arsenal007/TRX_UT3MK_v23/README.md

# TRX_UT3MK_v23
MAINBOARD for UT3MK v23.01
