arsenal007/TRX_UT3MK_v23/INPUTS/2976185.jpg

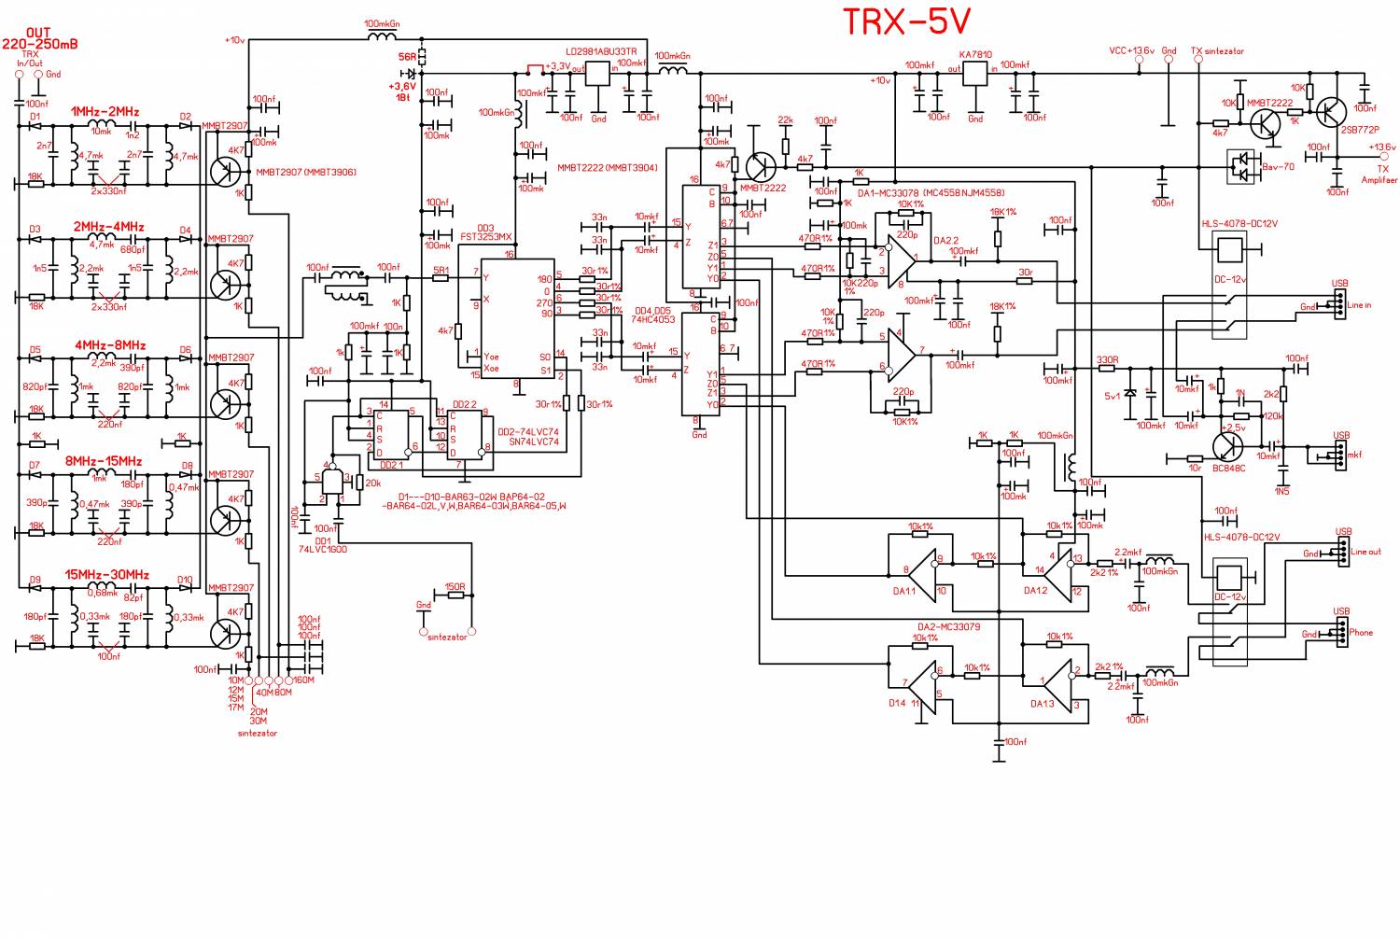
INPUTS/2976185.jpg
