arsenal007/TRX_UT3MK_v23/INPUTS/4894993.jpg

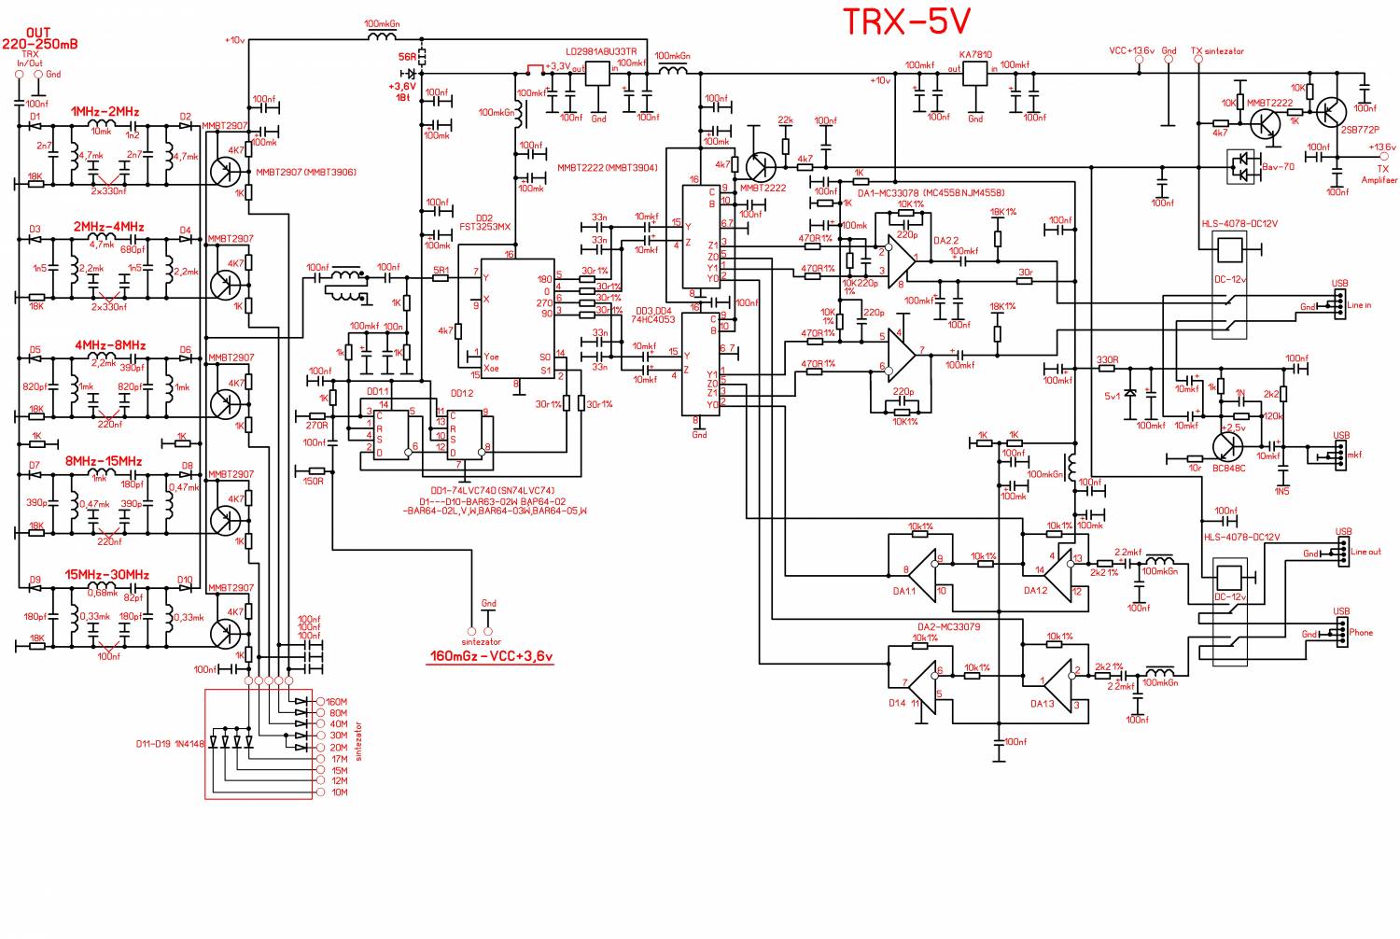
INPUTS/4894993.jpg
