arsenal007/TRX_UT3MK_v23/INPUTS/5522116.jpg

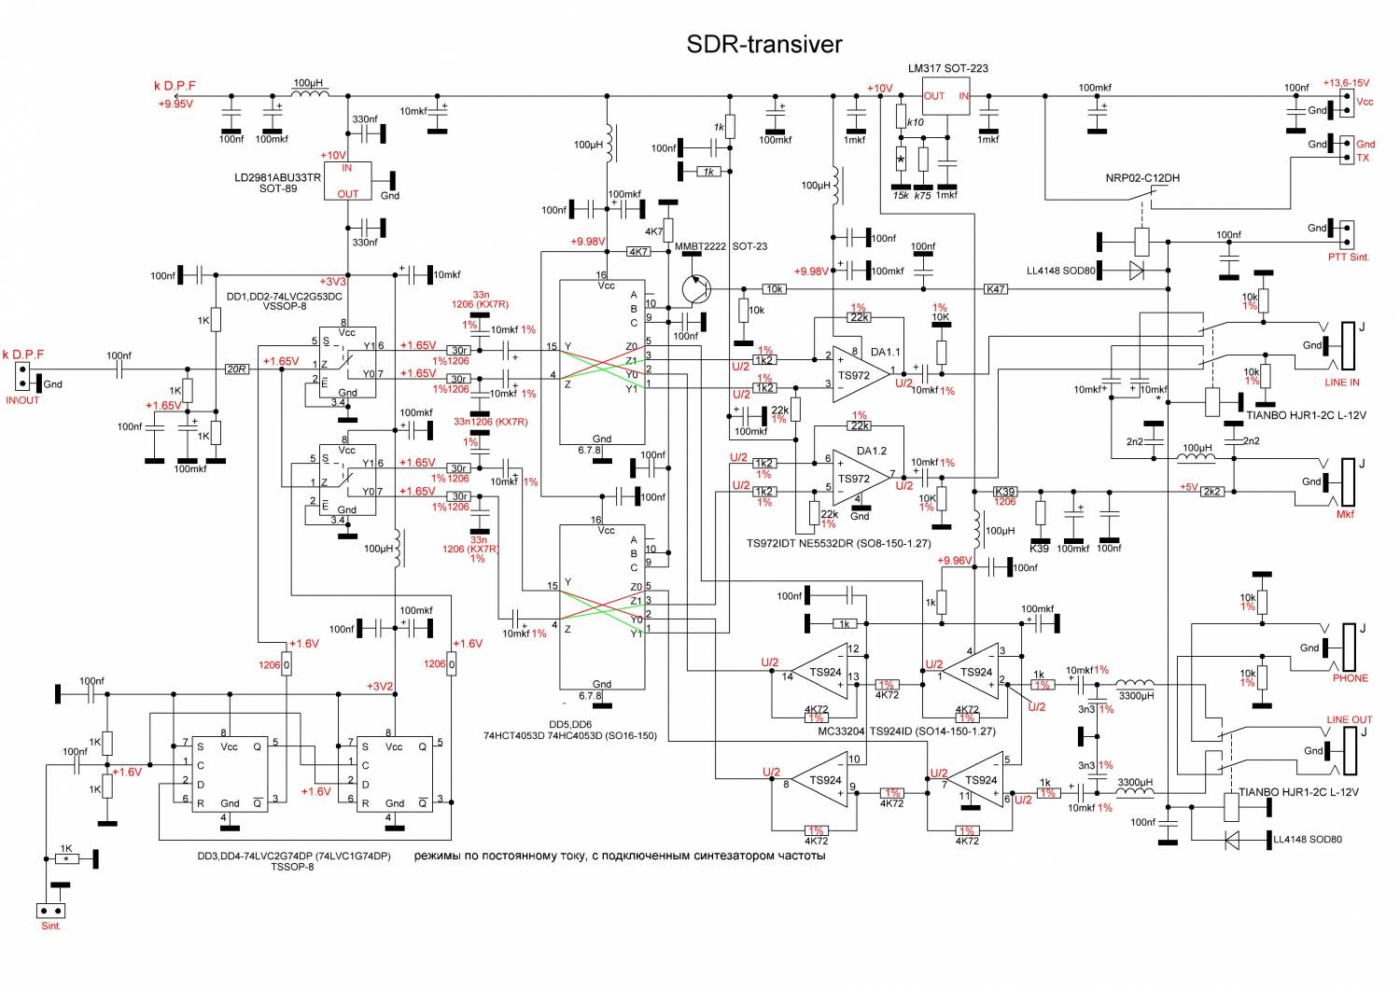
INPUTS/5522116.jpg
