arsenal007/TRX_UT3MK_v23/INPUTS/8518933.jpg

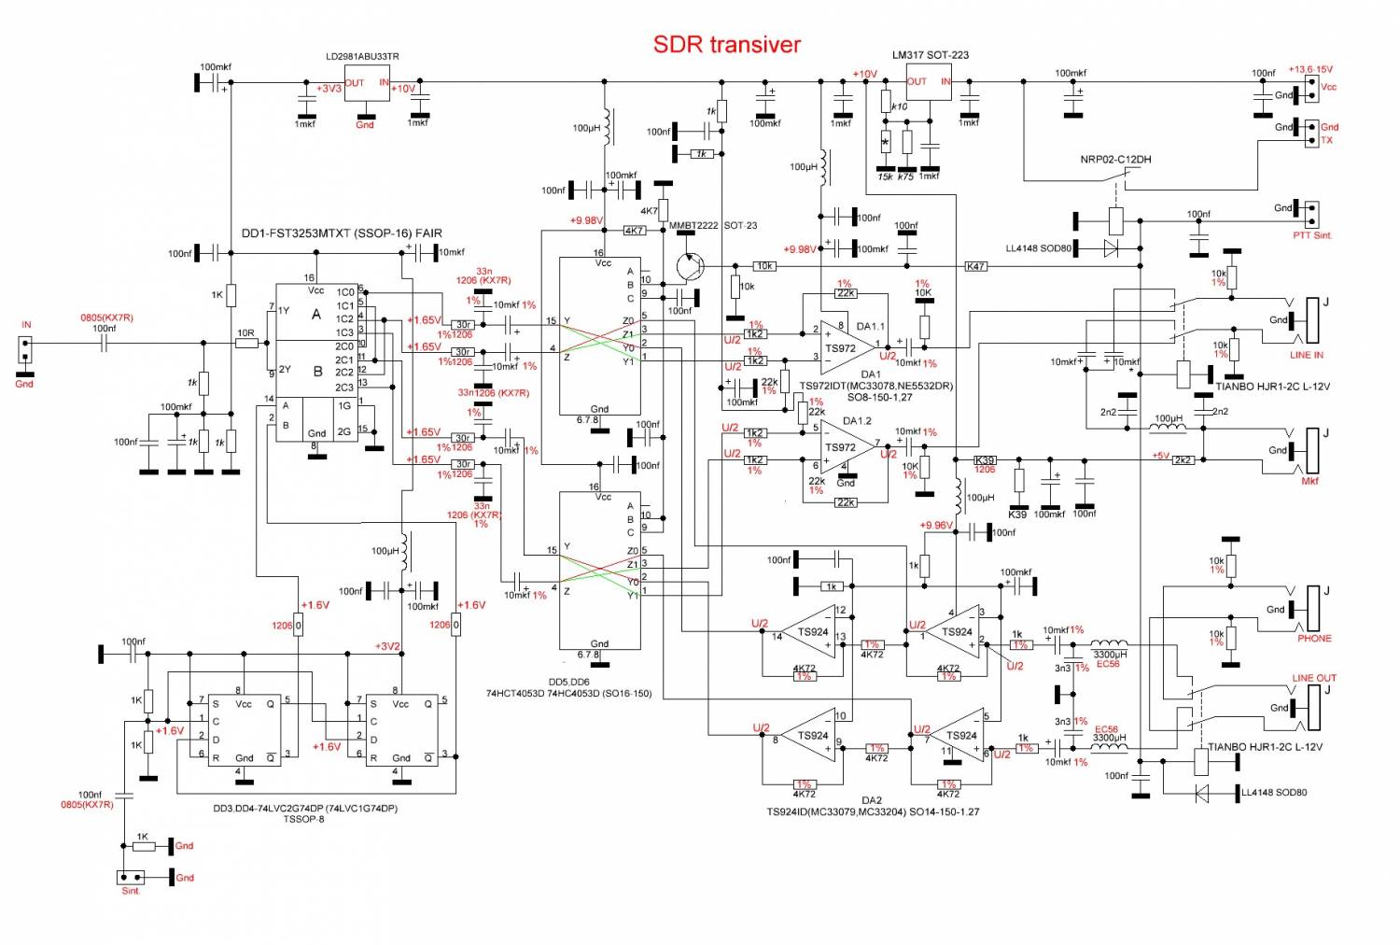
INPUTS/8518933.jpg
