arsenal007/TRX_UT3MK_v23/(list of files, drawings)

Other design files:
74HC74.ms12
