arsenal007/TRX_UT3MK_v23/LCSDR.kicad_pcb

## KiCad design LCSDR.kicad_pcb (2020-07-06)

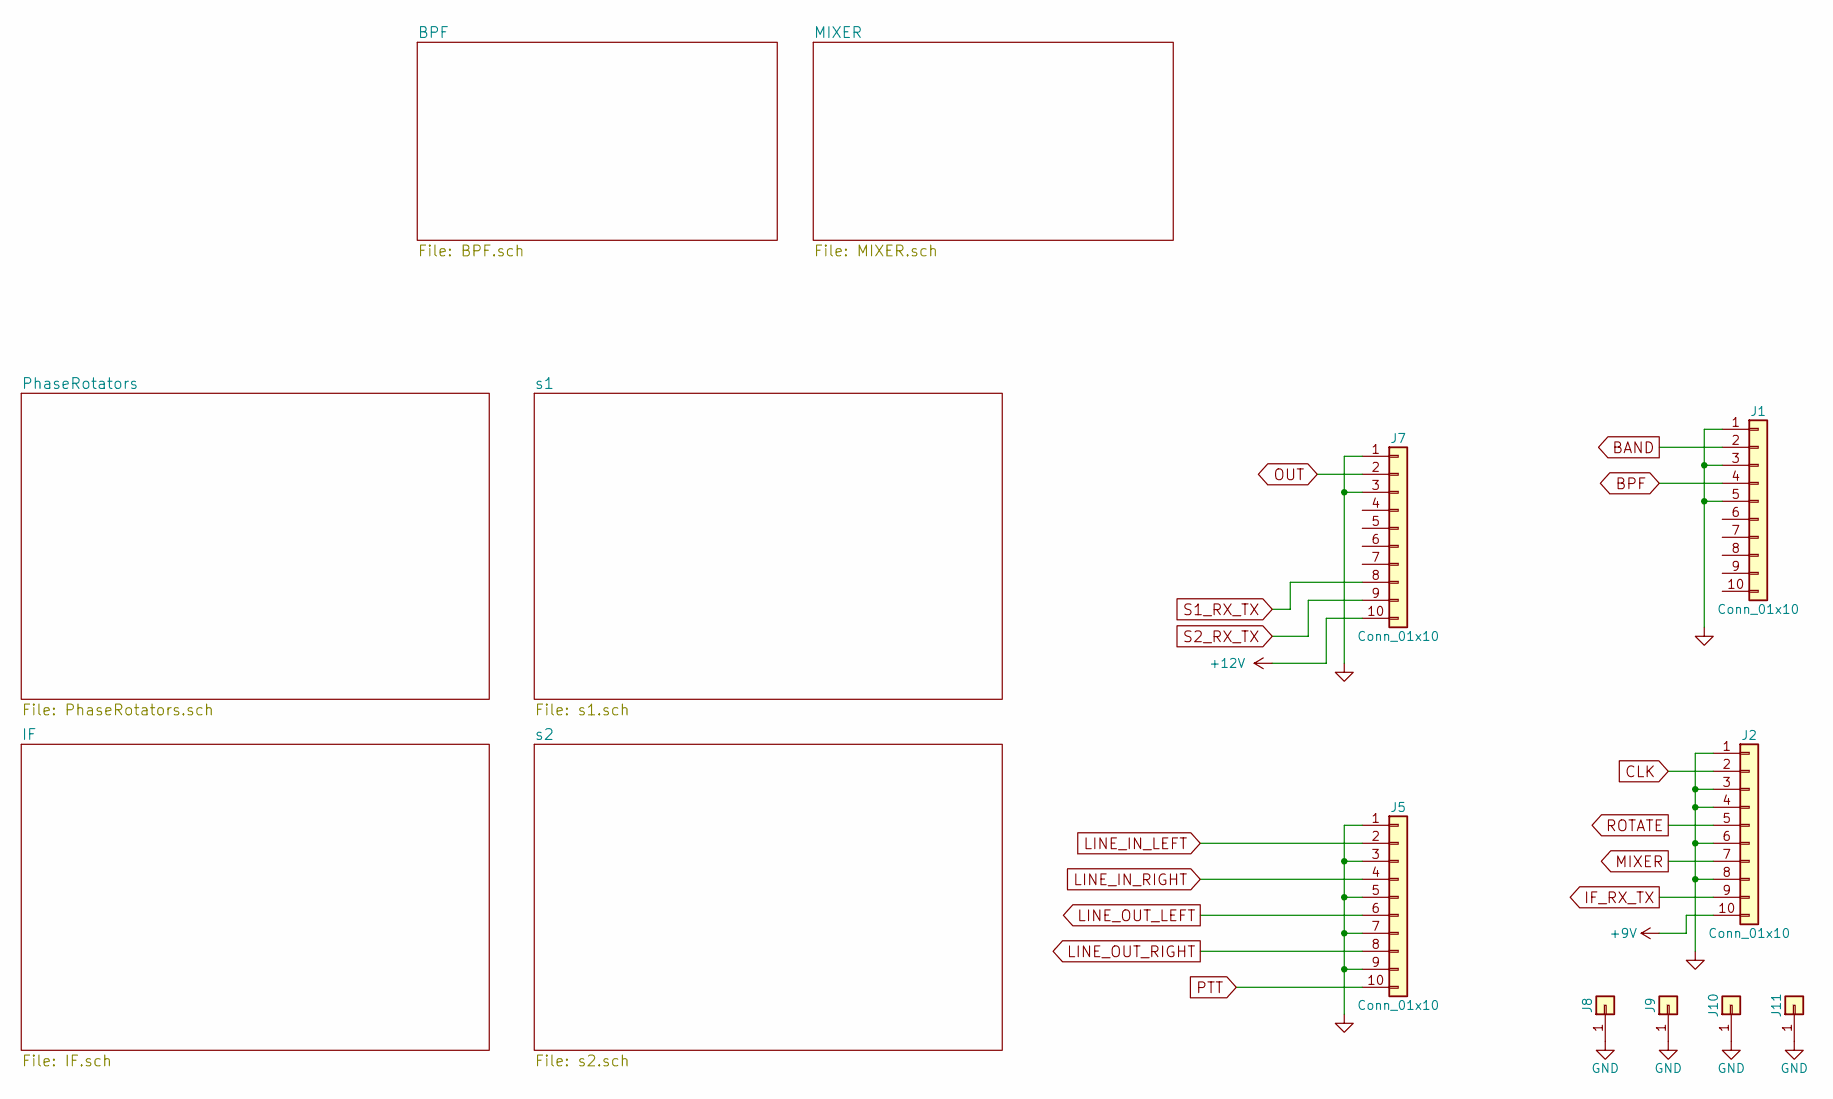
[picture p5: schematic LCSDR.sch, Hermes-Lite]

Parts:
J1, J2, J5, J7: Conn_01x10; Pin_Header_Straight_1x10_Pitch2.54mm
J8, J9, J10, J11: Conn_01x01; MountingHole_3.2mm_M3_DIN965_Pad

Connections:
+9V: J2.10; also elsewhere on the board
+12V: J7.10; also elsewhere on the board
BAND: J1.2; also elsewhere on the board
BPF: J1.4; also elsewhere on the board
CLK: J2.2; also elsewhere on the board
GND: J1.1, J1.3, J1.5, J2.1, J2.3, J2.4, J2.6, J2.8, J5.1, J5.3, J5.5, J5.7, J5.9, J7.1, J7.3, J8.1, J9.1, J10.1, J11.1; also elsewhere on the board
IF_RX_TX: J2.9; also elsewhere on the board
LINE_IN_LEFT: J5.2; also elsewhere on the board
LINE_IN_RIGHT: J5.4; also elsewhere on the board
LINE_OUT_LEFT: J5.6; also elsewhere on the board
LINE_OUT_RIGHT: J5.8; also elsewhere on the board
MIXER: J2.7; also elsewhere on the board
OUT: J7.2; also elsewhere on the board
PTT: J5.10; also elsewhere on the board
ROTATE: J2.5; also elsewhere on the board
S1_RX_TX: J7.8; also elsewhere on the board
S2_RX_TX: J7.9; also elsewhere on the board

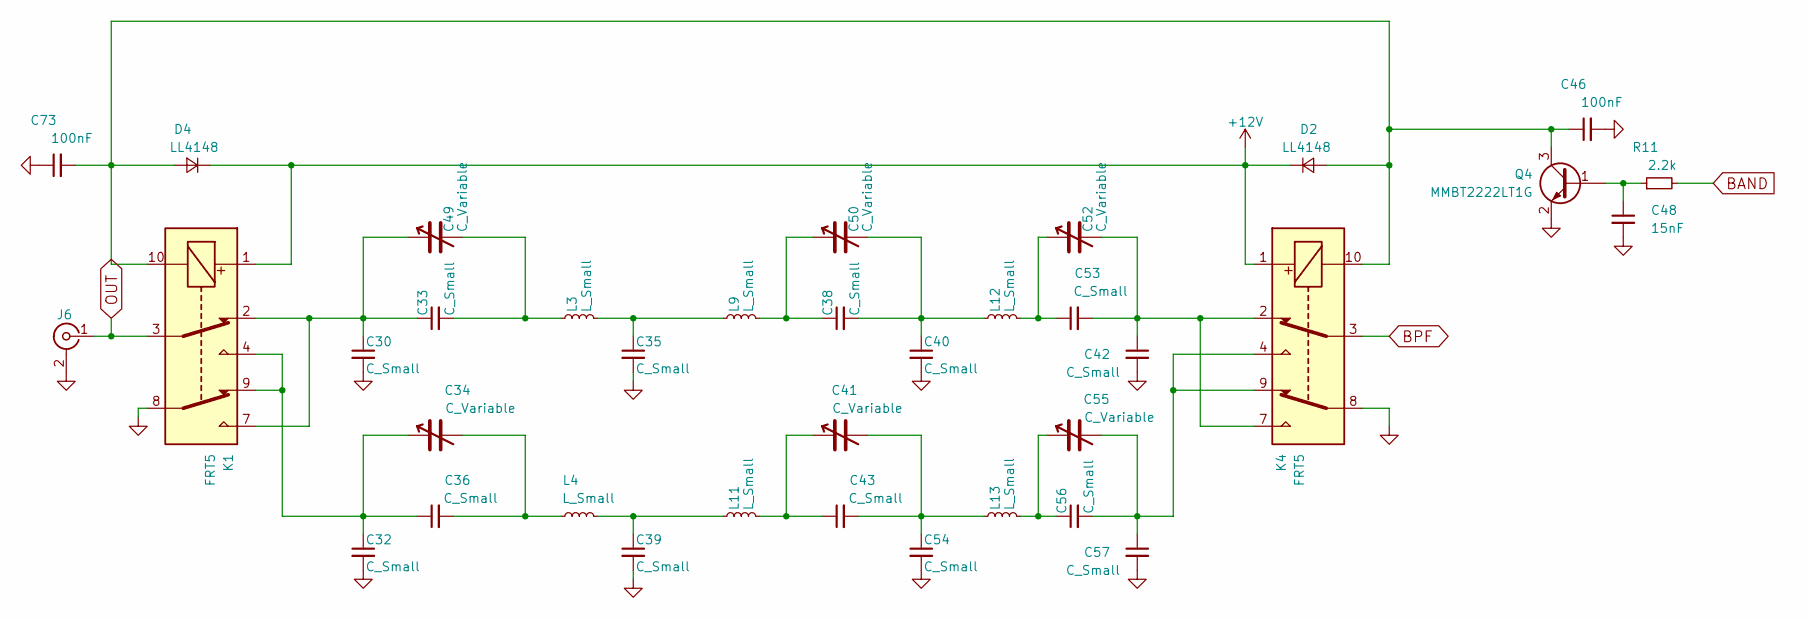
[picture p6: schematic BPF.sch]

Parts:
C30, C32, C33, C35, C36, C38, C39, C40, C42, C43, C53, C54, C56, C57: C_Small; C_1206_0603
C34, C41, C49, C50, C52, C55: C_Variable; C_Trimmer_Murata_TZC3
C46, C73: 100nF; C_1206_0603
C48: 15nF; C_0603_HandSoldering
D2, D4: LL4148; D_MiniMELF
J6: Conn_Coaxial; RFCONNECTOR
K1, K4: FRT5; Relay_DPDT_FRT5
L3, L4, L9, L11, L12, L13: L_Small; Choke_Toroid_6,5x13mm_Vertical
Q4: MMBT2222LT1G; SOT-23
R11: 2.2k; R_1206_0603

Connections:
+12V: D2.1 (K), D4.1 (K), K1.1, K4.1; also elsewhere on the board
BAND: R11.2; also elsewhere on the board
BPF: K4.3; also elsewhere on the board
GND: C30.2, C32.2, C35.2, C39.2, C40.2, C42.2, C46.2, C48.2, C54.2, C57.2, C73.1, J6.2 (Ext), K1.8, K4.8, Q4.2 (E); also elsewhere on the board
unnamed: C30.1, C33.1, C49.1, K1.2, K1.7
unnamed: C32.1, C34.1, C36.1, K1.4, K1.9
unnamed: C33.2, C49.2, L3.1
unnamed: C34.2, C36.2, L4.1
unnamed: C35.1, L3.2, L9.1
unnamed: C38.1, C50.1, L9.2
unnamed: C38.2, C40.1, C50.2, L12.1
unnamed: C39.1, L4.2, L11.1
unnamed: C41.1, C43.1, L11.2
unnamed: C41.2, C43.2, C54.1, L13.1
unnamed: C42.1, C52.2, C53.2, K4.2, K4.7
unnamed: C46.1, C73.2, D2.2 (A), D4.2 (A), K1.10, K4.10, Q4.3 (C)
unnamed: C48.1, Q4.1 (B), R11.1
unnamed: C52.1, C53.1, L12.2
unnamed: C55.1, C56.1, L13.2
unnamed: C55.2, C56.2, C57.1, K4.4, K4.9
OUT: J6.1 (In), K1.3; also elsewhere on the board

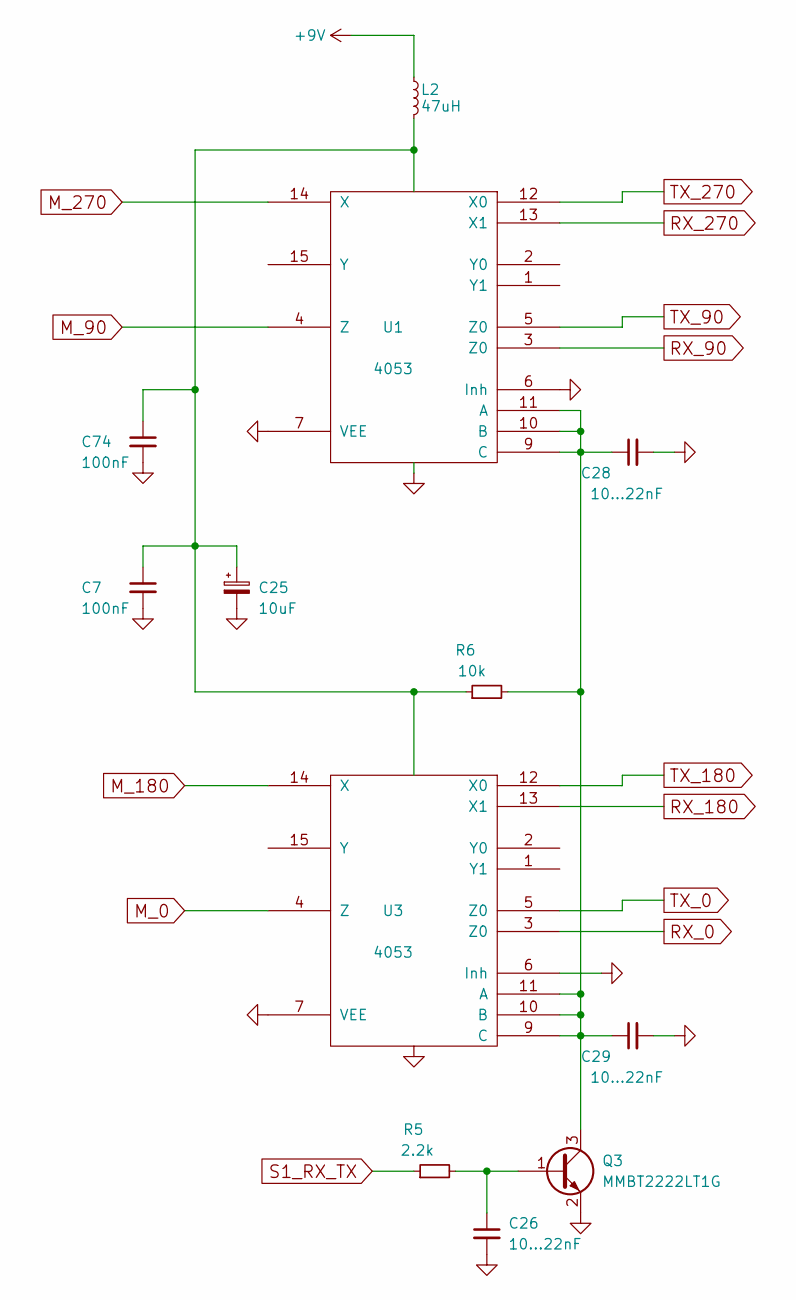
[picture p7: schematic s1.sch]

Parts:
C7, C74: 100nF; C_1206_0603
C25: 10uF; CP_Radial_D5.0mm_P2.00mm
C26, C28, C29: 10...22nF; C_0603_HandSoldering
L2: 47uH; Choke_Horizontal_RM10mm
Q3: MMBT2222LT1G; SOT-23
R5: 2.2k; R_1206_0603
R6: 10k; R_0603_HandSoldering
U1, U3: 4053; TSSOP-16_4.4x5mm_Pitch0.65mm

Connections:
+9V: L2.1; also elsewhere on the board
GND: C7.2, C25.2, C26.2, C28.2, C29.2, C74.2, Q3.2 (E), U1.6 (Inh), U1.7 (VEE), U1.8 (VSS), U3.6 (Inh), U3.7 (VEE), U3.8 (VSS); also elsewhere on the board
M_0: U3.4 (Z); also elsewhere on the board
M_90: U1.4 (Z); also elsewhere on the board
M_180: U3.14 (X); also elsewhere on the board
M_270: U1.14 (X); also elsewhere on the board
unnamed: C26.1, Q3.1 (B), R5.2
unnamed: C28.1, C29.1, Q3.3 (C), R6.2, U1.9 (C), U1.10 (B), U1.11 (A), U3.9 (C), U3.10 (B), U3.11 (A)
RX_0: U3.3 (Z0); also elsewhere on the board
RX_90: U1.3 (Z0); also elsewhere on the board
RX_180: U3.13 (X1); also elsewhere on the board
RX_270: U1.13 (X1); also elsewhere on the board
S1_RX_TX: R5.1; also elsewhere on the board
TX_0: U3.5 (Z0); also elsewhere on the board
TX_90: U1.5 (Z0); also elsewhere on the board
TX_180: U3.12 (X0); also elsewhere on the board
TX_270: U1.12 (X0); also elsewhere on the board
VDD: C7.1, C25.1, C74.1, L2.2, R6.1, U1.16 (VDD), U3.16 (VDD)

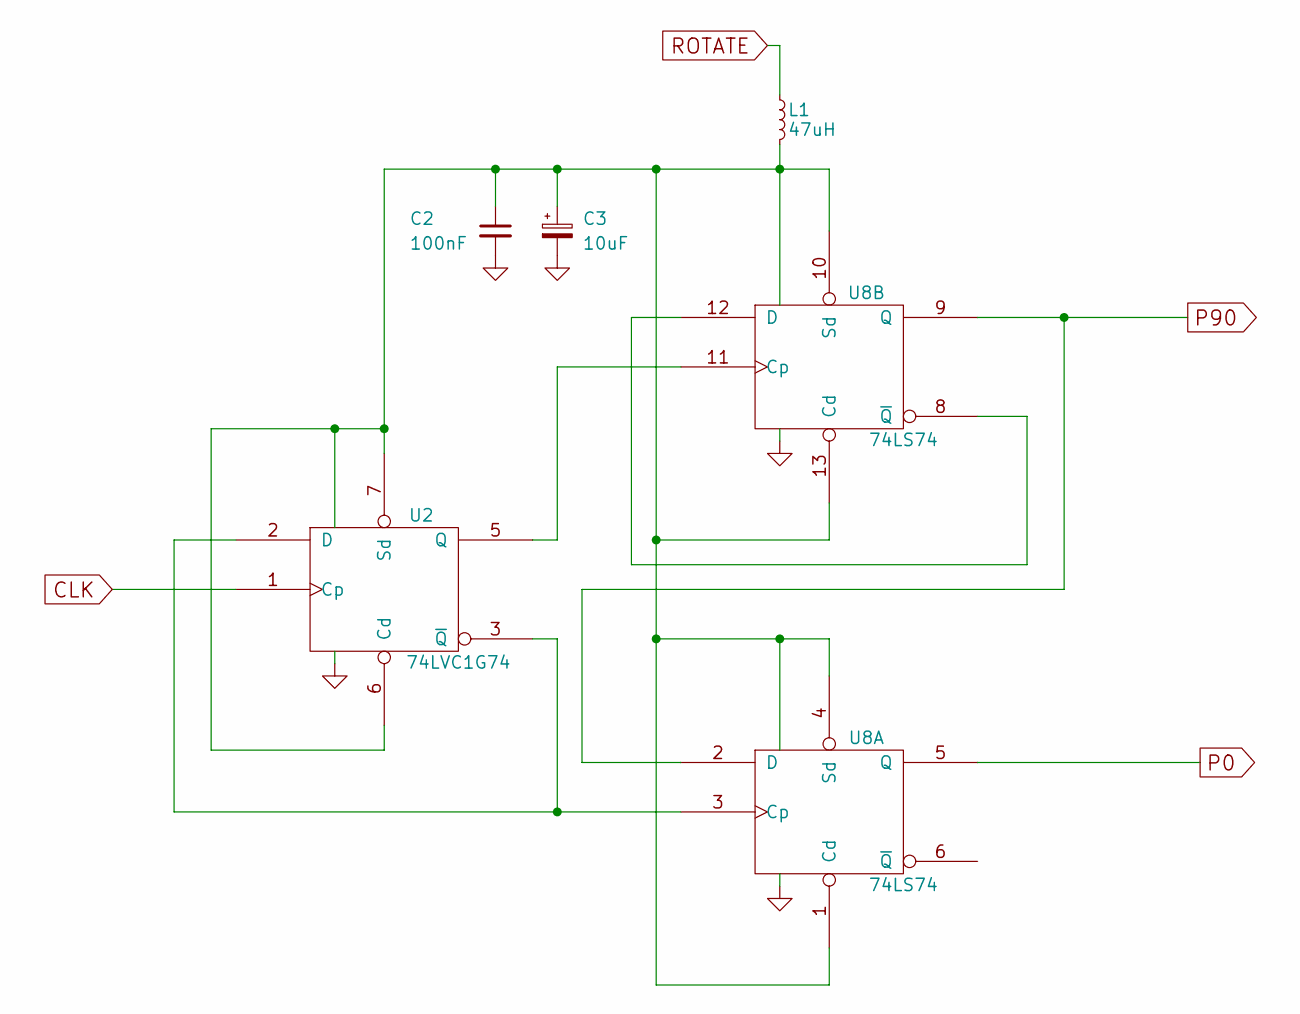
[picture p8: schematic PhaseRotators.sch]

Parts:
C2: 100nF; C_1206_0603
C3: 10uF; CP_Radial_D5.0mm_P2.00mm
L1: 47uH; Choke_Horizontal_RM10mm
U2: 74LVC1G74; TSSOP-8_3x3mm_Pitch0.65mm
U8: 74LS74; TSSOP-14_4.4x5mm_Pitch0.65mm

Connections:
CLK: U2.1 (Cp); also elsewhere on the board
GND: C2.2, C3.2, U2.4 (GND), U8.7 (GND); also elsewhere on the board
unnamed: U2.2 (D), U2.3 (~Q), U8.3 (Cp)
unnamed: U2.5 (Q), U8.11 (Cp)
unnamed: U8.8 (~Q), U8.12 (D)
P0: U8.5 (Q); also elsewhere on the board
P90: U8.2 (D), U8.9 (Q); also elsewhere on the board
ROTATE: L1.1; also elsewhere on the board
VCC: C2.1, C3.1, L1.2, U2.6 (Cd), U2.7 (Sd), U2.8 (VCC), U8.1 (Cd), U8.4 (Sd), U8.10 (Sd), U8.13 (Cd), U8.14 (VCC)

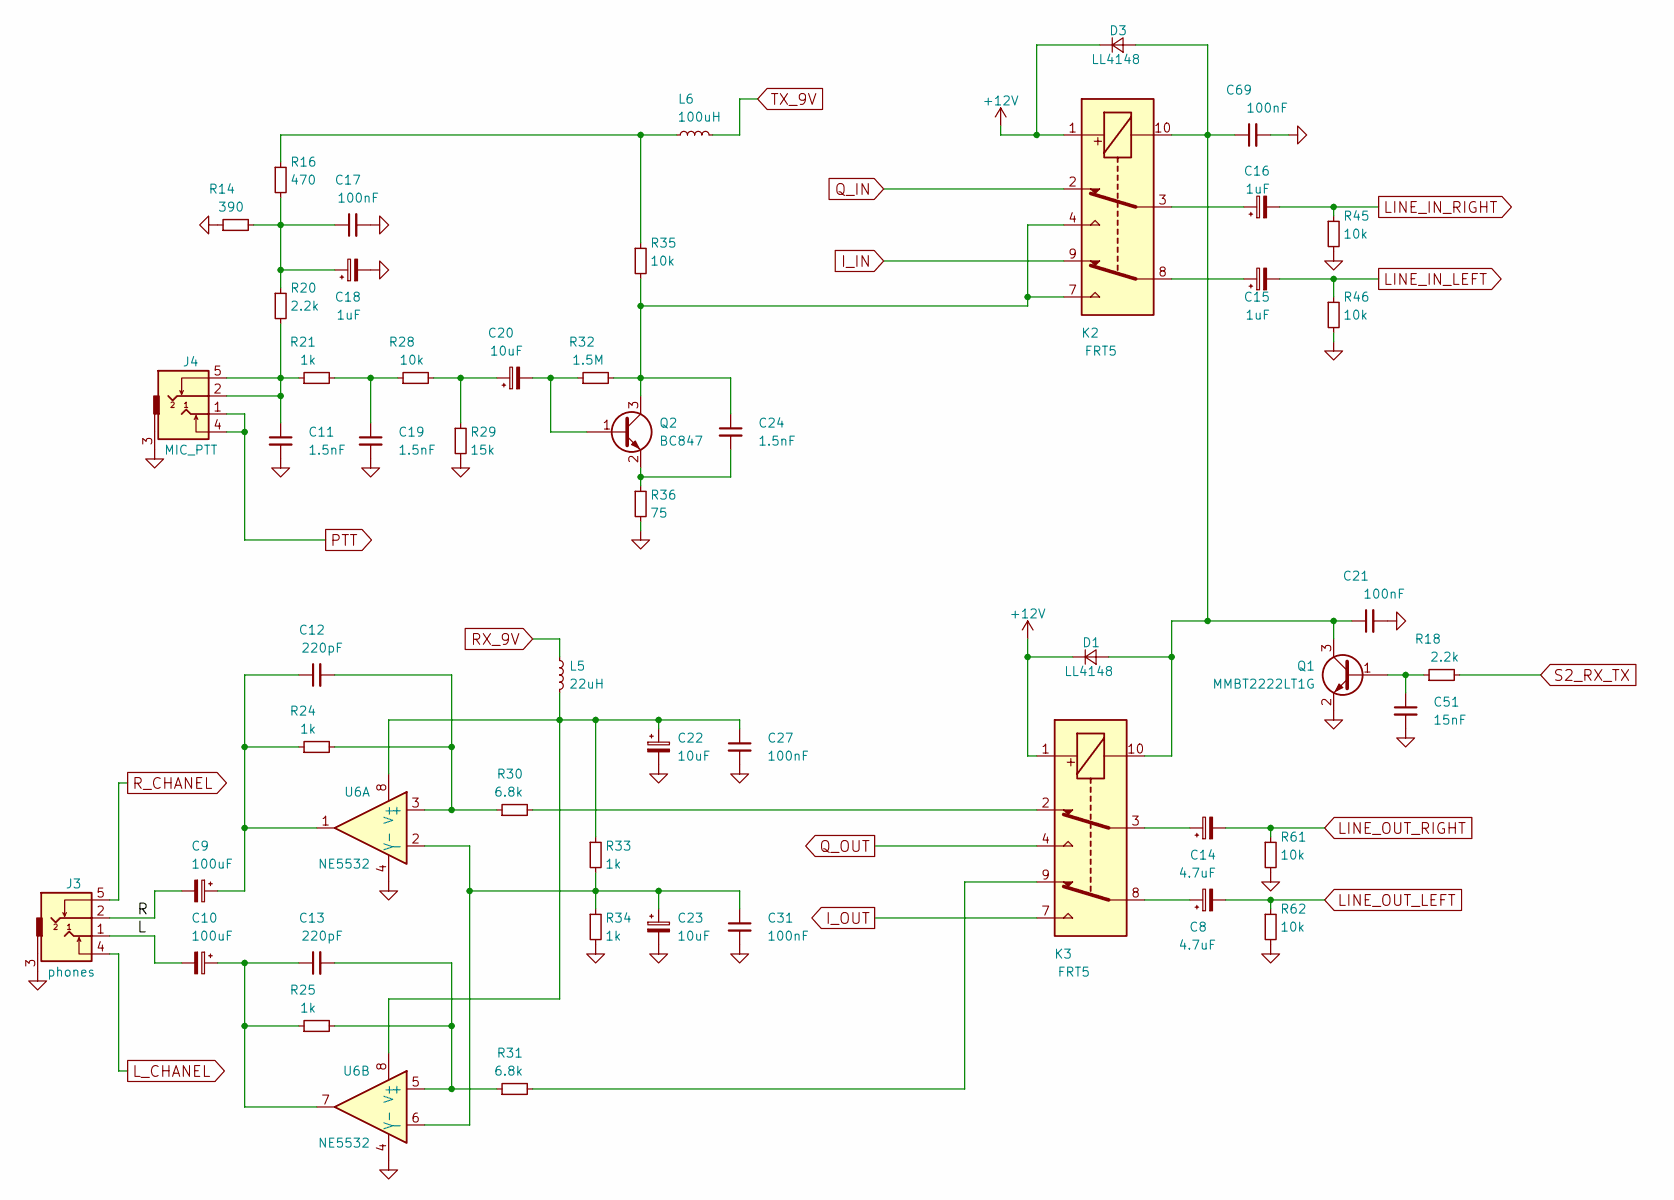
[picture p9: schematic s2.sch]

Parts:
C8, C14: 4.7uF; CP_Radial_D5.0mm_P2.00mm
C9, C10: 100uF; CP_Radial_D6.3mm_P2.50mm
C11, C19, C24: 1.5nF; C_1206_0603
C12, C13: 220pF; C_1206_0603
C15, C16, C18: 1uF; CP_Radial_D5.0mm_P2.00mm
C17, C21, C27, C31, C69: 100nF; C_1206_0603
C20, C22, C23: 10uF; CP_Radial_D5.0mm_P2.00mm
C51: 15nF; C_0603_HandSoldering
D1, D3: LL4148; D_MiniMELF
J3: phones; audio_jack_3_5mm_PJ307
J4: MIC_PTT; audio_jack_3_5mm_PJ307
K2, K3: FRT5; Relay_DPDT_FRT5
L5: 22uH; Choke_Horizontal_RM10mm
L6: 100uH; Choke_Horizontal_RM10mm
Q1: MMBT2222LT1G; SOT-23
Q2: BC847; SOT-23
R14: 390; R_1206_0603
R16: 470; R_1206_0603
R18, R20: 2.2k; R_1206_0603
R21, R24, R25, R33, R34: 1k; R_1206_0603
R28, R35, R45, R46, R61, R62: 10k; R_1206_0603
R29: 15k; R_1206_0603
R30, R31: 6.8k; R_1206_0603
R32: 1.5M; R_1206_0603
R36: 75; R_1206_0603
U6: NE5532; SOIC-8_3.9x4.9mm_Pitch1.27mm

Connections:
+12V: D1.1 (K), D3.1 (K), K2.1, K3.1; also elsewhere on the board
/s2/L: C10.2, J3.1
/s2/R: C9.2, J3.2
GND: C11.2, C17.2, C18.2, C19.2, C21.2, C22.2, C23.2, C27.2, C31.2, C51.2, C69.2, J3.3, J4.3, Q1.2 (E), R14.1, R29.2, R34.2, R36.2, R45.2, R46.2, R61.2, R62.2, U6.4 (V-); also elsewhere on the board
I_IN: K2.9; also elsewhere on the board
I_OUT: K3.7; also elsewhere on the board
LINE_IN_LEFT: C15.2, R46.1; also elsewhere on the board
LINE_IN_RIGHT: C16.2, R45.1; also elsewhere on the board
LINE_OUT_LEFT: C8.2, R62.1; also elsewhere on the board
LINE_OUT_RIGHT: C14.2, R61.1; also elsewhere on the board
unnamed: C8.1, K3.8
unnamed: C10.1, C13.1, R25.1, U6.7
unnamed: C11.1, J4.2, J4.5, R20.2, R21.1
unnamed: C9.1, C12.1, R24.1, U6.1
unnamed: C12.2, R24.2, R30.1, U6.3 (+)
unnamed: C13.2, R25.2, R31.1, U6.5 (+)
unnamed: C14.1, K3.3
unnamed: C15.1, K2.8
unnamed: C16.1, K2.3
unnamed: C17.1, C18.1, R14.2, R16.2, R20.1
unnamed: C19.1, R21.2, R28.1
unnamed: C20.1, R28.2, R29.1
unnamed: C20.2, Q2.1 (B), R32.1
unnamed: C21.1, C69.1, D1.2 (A), D3.2 (A), K2.10, K3.10, Q1.3 (C)
unnamed: C22.1, C27.1, L5.2, R33.1, U6.8 (V+)
unnamed: C23.1, C31.1, R33.2, R34.1, U6.2 (-), U6.6 (-)
unnamed: C24.1, K2.4, K2.7, Q2.3 (C), R32.2, R35.2
unnamed: C24.2, Q2.2 (E), R36.1
unnamed: C51.1, Q1.1 (B), R18.1
unnamed: K3.2, R30.2
unnamed: K3.9, R31.2
unnamed: L6.1, R16.1, R35.1
PTT: J4.1, J4.4; also elsewhere on the board
Q_IN: K2.2; also elsewhere on the board
Q_OUT: K3.4; also elsewhere on the board
RX_9V: L5.1; also elsewhere on the board
S2_RX_TX: R18.2; also elsewhere on the board
TX_9V: L6.2; also elsewhere on the board

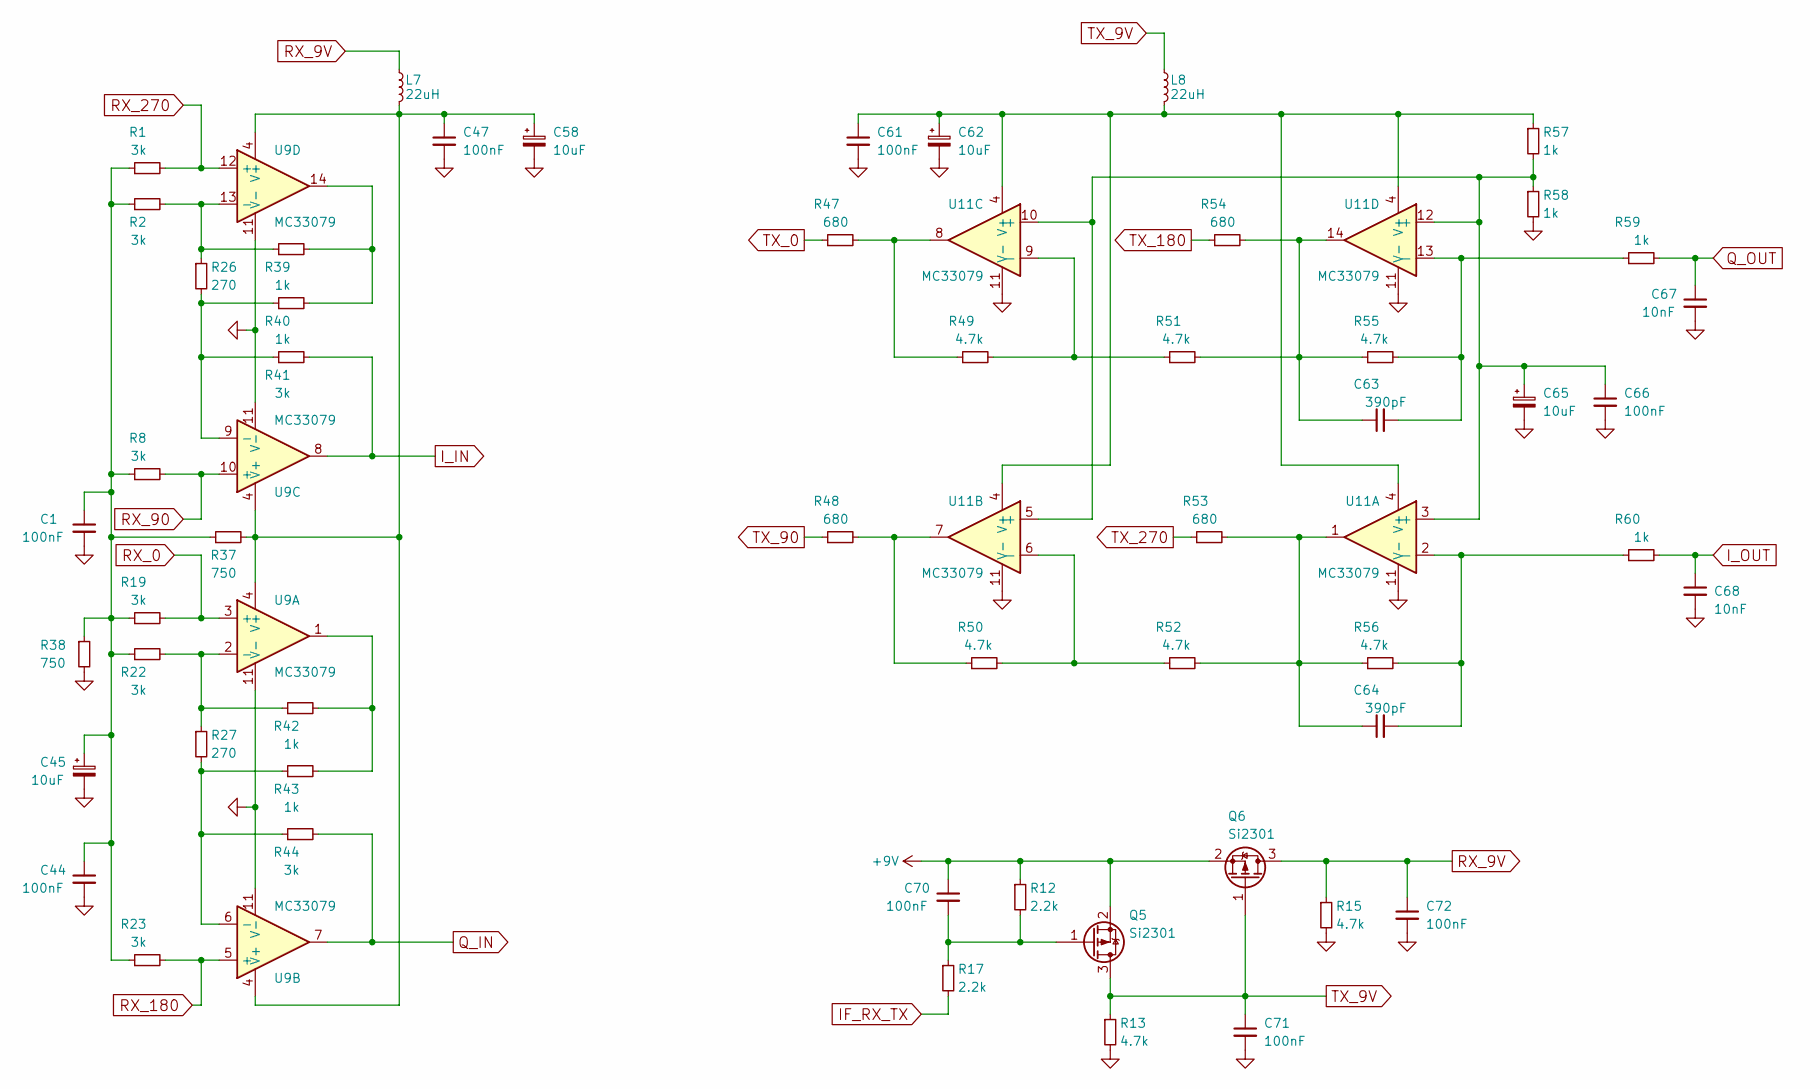
[picture p10: schematic IF.sch]

Parts:
C1, C44, C47, C61, C66, C70, C71, C72: 100nF; C_1206_0603
C45, C58, C62, C65: 10uF; CP_Radial_D5.0mm_P2.00mm
C63, C64: 390pF; C_0603_HandSoldering
C67, C68: 10nF; C_0603_HandSoldering
L7: 22uH; Choke_Horizontal_RM10mm
L8: 22uH; Choke_Horizontal_RM15mm
Q5, Q6: Si2301; SOT-23
R1, R2, R8, R19, R22, R23, R41, R44: 3k; R_0603_HandSoldering
R12, R17: 2.2k; R_1206_0603
R13, R15: 4.7k; R_1206_0603
R26, R27: 270; R_0603_HandSoldering
R37, R38: 750; R_1206_0603
R39, R40, R42, R43, R59, R60: 1k; R_0603_HandSoldering
R47, R48, R53, R54: 680; R_0603_HandSoldering
R49, R50, R51, R52, R55, R56: 4.7k; R_0603_HandSoldering
R57, R58: 1k; R_1206_0603
U9, U11: MC33079; SOIC-14_3.9x8.7mm_Pitch1.27mm

Connections:
+9V: C70.1, Q5.2 (S), Q6.2 (S), R12.1; also elsewhere on the board
GND: C1.2, C44.2, C45.2, C47.2, C58.2, C61.2, C62.2, C65.2, C66.2, C67.2, C68.2, C71.2, C72.2, R13.2, R15.2, R38.2, R58.2, U9.11 (V-), U11.11 (V-); also elsewhere on the board
IF_RX_TX: R17.2; also elsewhere on the board
I_IN: R41.2, U9.8; also elsewhere on the board
I_OUT: C68.1, R60.2; also elsewhere on the board
unnamed: C1.1, C44.1, C45.1, R1.1, R2.1, R8.1, R19.1, R22.1, R23.1, R37.1, R38.1
unnamed: C47.1, C58.1, L7.2, R37.2, U9.4 (V+)
unnamed: C61.1, C62.1, L8.2, R57.1, U11.4 (V+)
unnamed: C63.1, R51.2, R54.2, R55.1, U11.14
unnamed: C63.2, R55.2, R59.1, U11.13 (-)
unnamed: C64.1, R52.2, R53.2, R56.1, U11.1
unnamed: C64.2, R56.2, R60.1, U11.2 (-)
unnamed: C65.1, C66.1, R57.2, R58.1, U11.3 (+), U11.5 (+), U11.10 (+), U11.12 (+)
unnamed: C70.2, Q5.1 (G), R12.2, R17.1
unnamed: R2.2, R26.1, R39.1, U9.13 (-)
unnamed: R22.2, R27.1, R42.1, U9.2 (-)
unnamed: R26.2, R40.1, R41.1, U9.9 (-)
unnamed: R27.2, R43.1, R44.1, U9.6 (-)
unnamed: R39.2, R40.2, U9.14
unnamed: R42.2, R43.2, U9.1
unnamed: R47.2, R49.1, U11.8
unnamed: R48.2, R50.1, U11.7
unnamed: R49.2, R51.1, U11.9 (-)
unnamed: R50.2, R52.1, U11.6 (-)
Q_IN: R44.2, U9.7; also elsewhere on the board
Q_OUT: C67.1, R59.2; also elsewhere on the board
RX_0: R19.2, U9.3 (+); also elsewhere on the board
RX_9V: C72.1, L7.1, Q6.3 (D), R15.1; also elsewhere on the board
RX_90: R8.2, U9.10 (+); also elsewhere on the board
RX_180: R23.2, U9.5 (+); also elsewhere on the board
RX_270: R1.2, U9.12 (+); also elsewhere on the board
TX_0: R47.1; also elsewhere on the board
TX_9V: C71.1, L8.1, Q5.3 (D), Q6.1 (G), R13.1; also elsewhere on the board
TX_90: R48.1; also elsewhere on the board
TX_180: R54.1; also elsewhere on the board
TX_270: R53.1; also elsewhere on the board

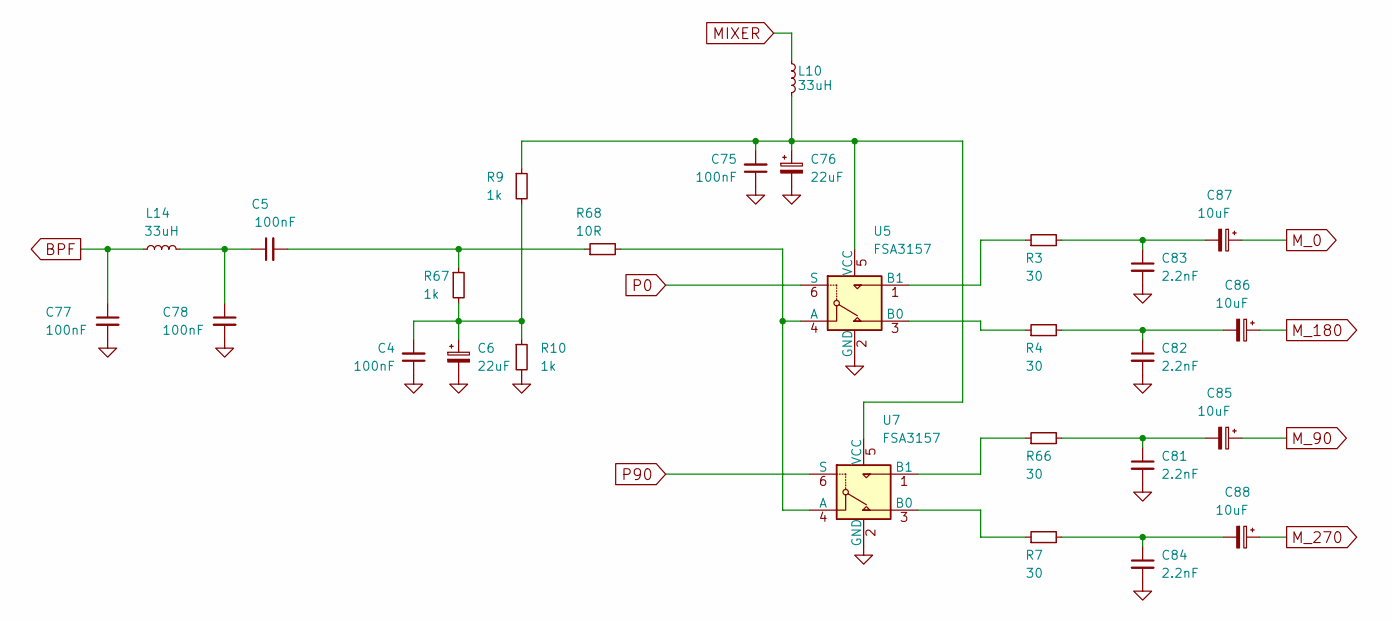
[picture p11: schematic MIXER.sch]

Parts:
C4, C75: 100nF; C_1206_0603
C5, C77, C78: 100nF; C_Disc_D7.0mm_W2.5mm_P5.00mm
C6, C76: 22uF; CP_Radial_D5.0mm_P2.00mm
C81, C82, C83, C84: 2.2nF; C_1206_0603
C85, C86, C87, C88: 10uF; CP_Tantalum_Case-A_EIA-3216-18_Wave
L10, L14: 33uH; Choke_Horizontal_RM10mm
R3, R4, R7, R66: 30; R_1206_0603
R9, R10, R67: 1k; R_1206_0603
R68: 10R; R_1206_0603
U5, U7: FSA3157; SOT-23-6

Connections:
BPF: C77.1, L14.1; also elsewhere on the board
GND: C4.1, C6.2, C75.1, C76.2, C77.2, C78.2, C81.2, C82.2, C83.2, C84.2, R10.2, U5.2 (GND), U7.2 (GND); also elsewhere on the board
MIXER: L10.1; also elsewhere on the board
M_0: C87.1; also elsewhere on the board
M_90: C85.1; also elsewhere on the board
M_180: C86.1; also elsewhere on the board
M_270: C88.1; also elsewhere on the board
unnamed: C4.2, C6.1, R9.2, R10.1, R67.2
unnamed: C5.1, C78.1, L14.2
unnamed: C5.2, R67.1, R68.1
unnamed: C75.2, C76.1, L10.2, R9.1, U5.5 (VCC), U7.5 (VCC)
unnamed: C81.1, C85.2, R66.2
unnamed: C82.1, C86.2, R4.2
unnamed: C83.1, C87.2, R3.2
unnamed: C84.1, C88.2, R7.2
unnamed: R3.1, U5.1 (B1)
unnamed: R4.1, U5.3 (B0)
unnamed: R7.1, U7.3 (B0)
unnamed: R66.1, U7.1 (B1)
unnamed: R68.2, U5.4 (A), U7.4 (A)
P0: U5.6 (S); also elsewhere on the board
P90: U7.6 (S); also elsewhere on the board

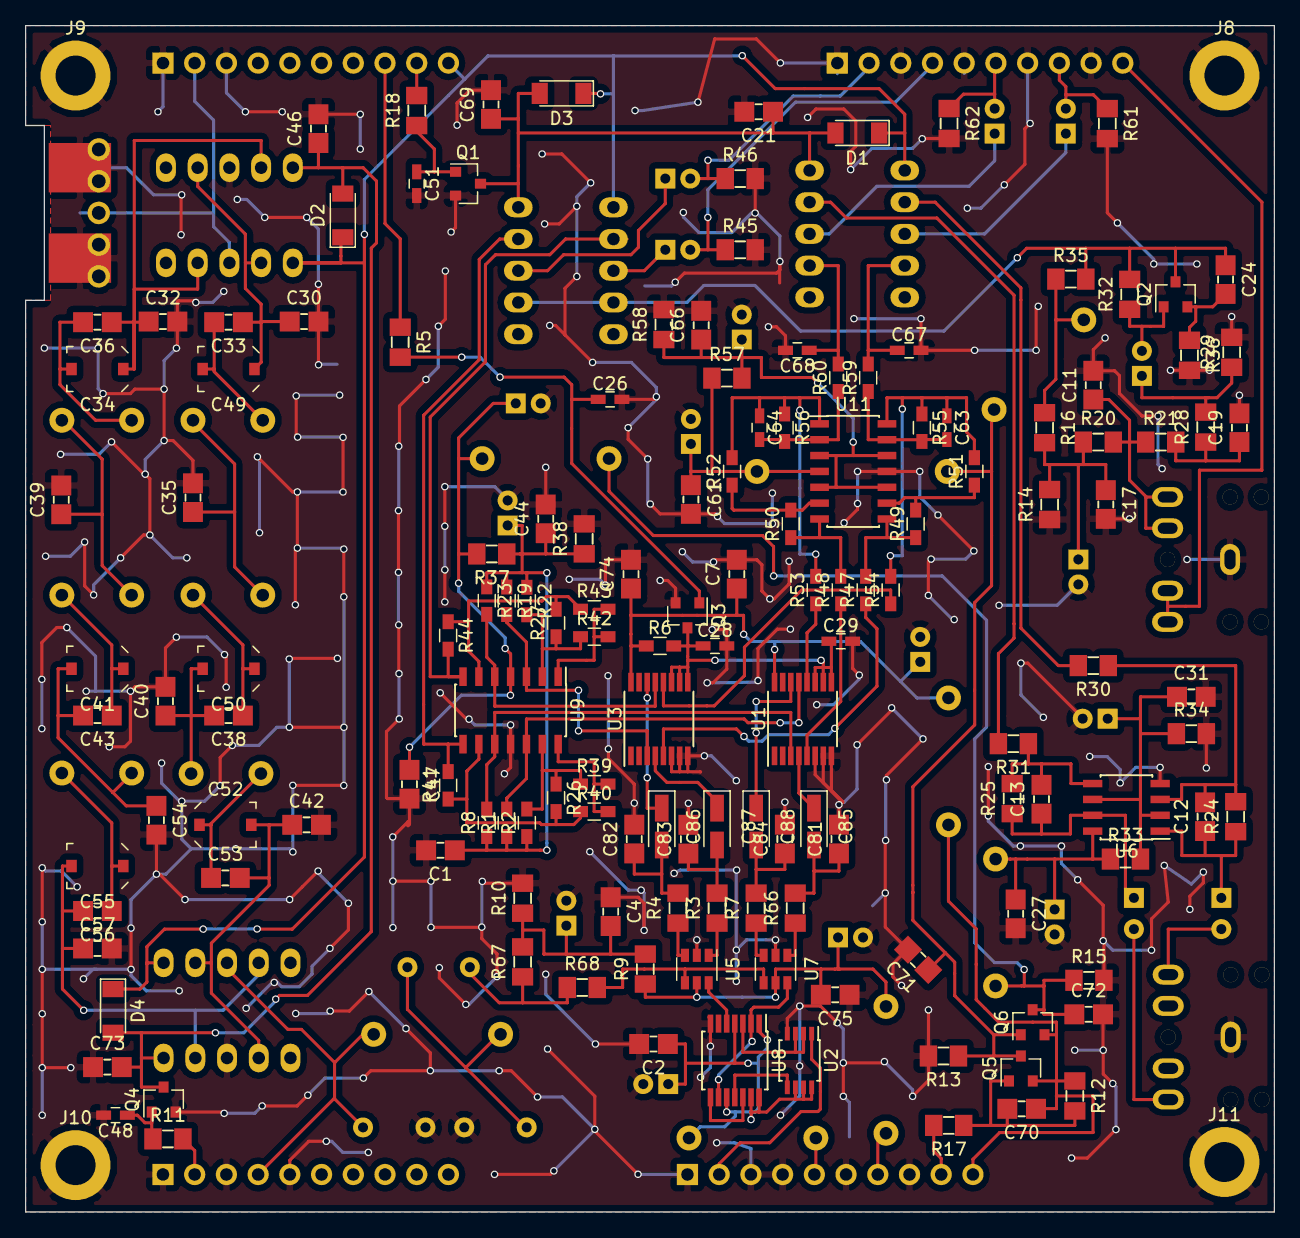
[picture p12: board LCSDR.kicad_pcb from above]

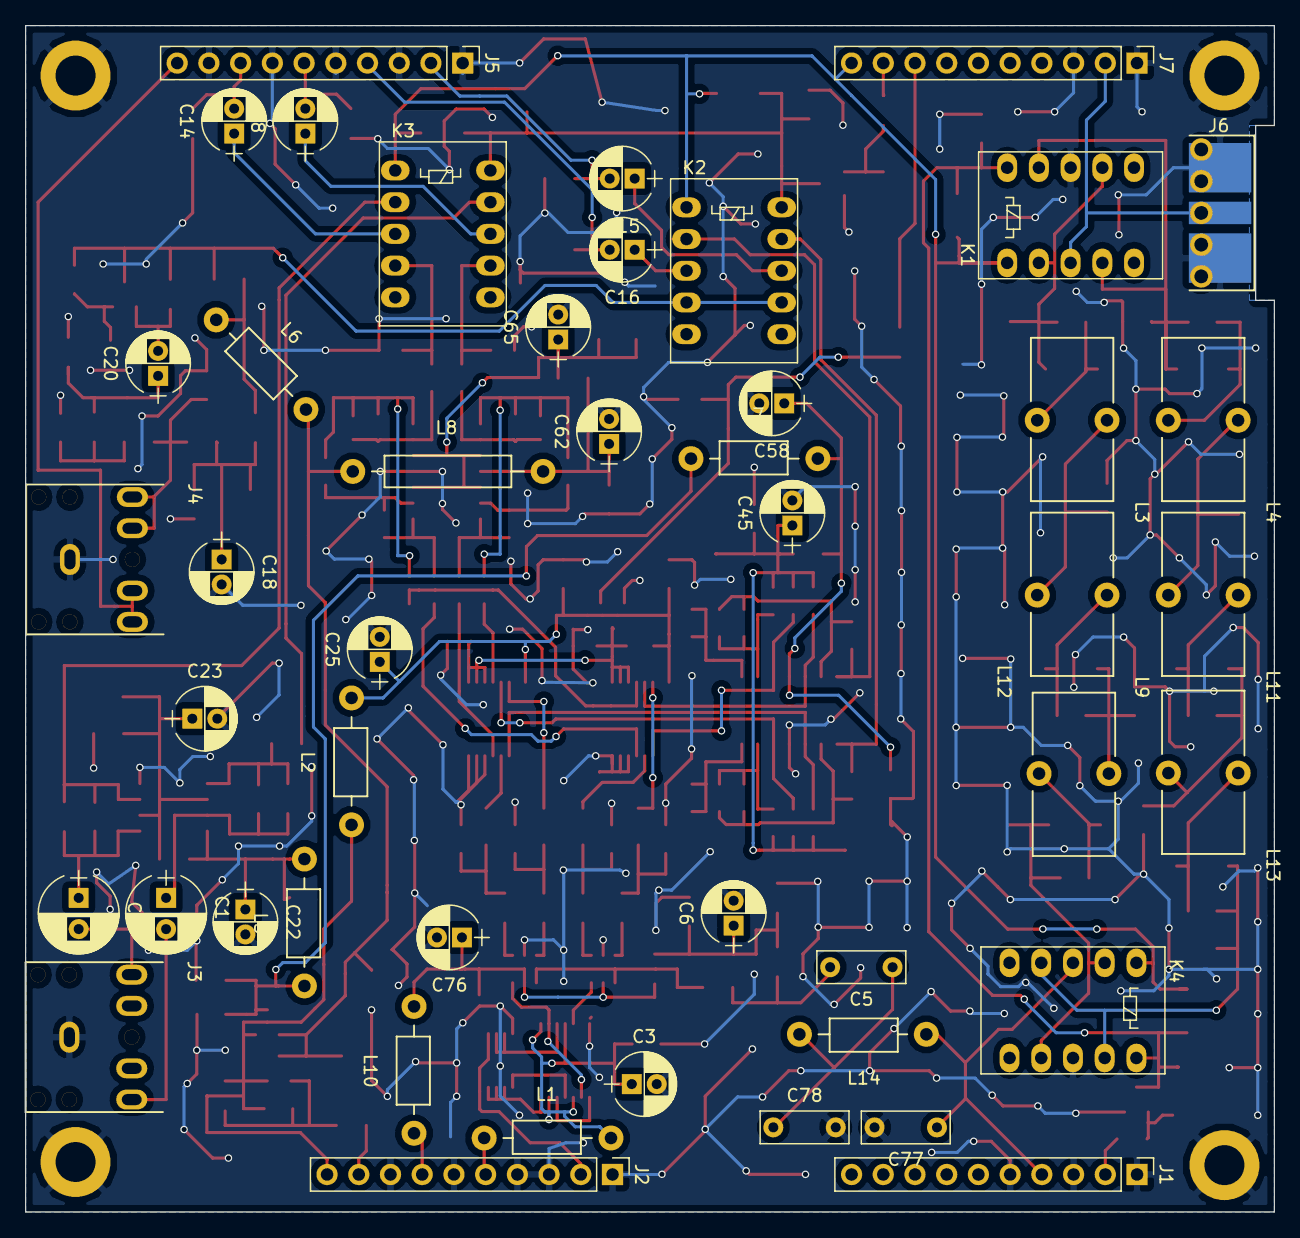
[picture p13: board LCSDR.kicad_pcb from below]

Board: 2 copper layers, 100.0 x 95.0 mm, 196 parts (46 on the bottom side), 116 nets.
