arsenal007/TRX_UT3MK_v23/PowerSupplay/LCSDR.kicad_pcb

## KiCad design PowerSupplay/LCSDR.kicad_pcb (2020-05-04)

Schematic: LCSDR.sch, Hermes-Lite

Parts:
C1, C2, C4, C17, C46, C79, C95: 10uF; Universal_C_Radial_D5_L11_P2_tantal
C3, C5, C6, C14, C15, C16, C18, C22, C29, C31, C35, C47, C53, C68, C70, C72, C73, C74, C76, C78, C82, C87, C89, C94, C96: 100nF; C_1206_0603
C7, C8, C9, C13, C52: 10uF; CP_Tantalum_Case-A_EIA-3216-18_Hand
C10, C21, C24, C25, C40, C54, C67, C81, C91, C100, C101, C102, C103: 1uF; C_1206_0603
C11, C12: 22pF; C_1206_0603
C19, C30, C41, C48, C80: 10uF 16v; CP_Tantalum_Case-A_EIA-3216-18_Hand
C20, C77, C83, C92: 100uF; C_Radial_D5_L11_P2.5
C23, C33, C43, C51: 27nF; C_1206_0603
C26: 120pF; C_0603_HandSoldering
C27, C28: 270pF; C_1206_0603
C32, C36, C39: 680pF; C_0603_HandSoldering
C34, C56, C86, C93, C104, C105, C106, C107, C108, C110, C111: 15nF; C_0603_HandSoldering
C37, C38, C45, C49: 820pF; C_0603_HandSoldering
C42: 47uF; CP_Elec_6.3x7.7
C44, C61, C65: 360pF; C_0603_HandSoldering
C50, C62, C63: 33pF; C_0603_HandSoldering
C55, C98: 1000uF; CP_Radial_D8.0mm_P3.50mm
C57, C97: 180pF; C_0603_HandSoldering
C58, C66: 6.8uF; CP_Tantalum_Case-A_EIA-3216-18_Hand
C59, C64: 10n; C_1206_0603
C60, C69: 390p; C_0603_HandSoldering
C71: 1n; C_1206_0603
C75: 330uF; C_Radial_D10_L13_P5
C84, C85, C88, C90: 4.7uF; C_0603_HandSoldering
C109: 15n; C_0603_HandSoldering
CON1: +13,8v; BARREL_JACK
D1: LL4148; D_MiniMELF_Handsoldering
D11: LED; LED_D5.0mm
D12: WE-TVS824011; SOT-23-5_HandSoldering
J2: LINE OUT; audio_jack_3_5mm_PJ307
K1: LU-12; Relay_SPDT_HJR-4102
L1, L6, L24, L26: 100uH; Resistor_Horizontal_RM10mm
L2: 4.7uH; Choke_CD54
L3, L4, L5, L10, L22, L25: 47uH; Resistor_Horizontal_RM10mm
L7, L20, L21: 470nH; R_1210_HandSoldering
L8, L9: 220nH; R_1210_HandSoldering
L11: 4.7uH; R_1210_HandSoldering
L12, L13: 472K; Resistor_Horizontal_RM10mm
L14, L15, L16: 2.2uH; R_1210_HandSoldering
L17, L18, L19: 1uH; R_1210_HandSoldering
L23: 0.47uH; R_1210_HandSoldering
P1: BNC; BNC_Socket_TYCO-AMP
P2: SPI; Pin_Header_Straight_2x03_Pitch2.54mm
P3: USB_OTG; USB_Mini-B
P4: PA_TX; Pin_Header_Straight_1x02_Pitch2.54mm
P5: ENCODER; Pin_Header_Straight_1x04_Pitch2.54mm
P10, P11, P12, P13: CONN_01X01; MountingHole_3.2mm_M3_ISO7380_Pad
Q1: IRF510N; TO-220_Horizontal_Reversed
Q2: MMBT2222LT1G; SOT-23_Handsoldering
Q3: BFG135; SOT-223
Q4: PMBT2907; SOT-23_Handsoldering
Q5, Q6: PMBT2222; SOT-23_Handsoldering
R1, R2, R9, R10, R18, R21, R26, R27: 3k 1%; R_0603_HandSoldering
R3, R5, R22, R25, R39, R45: 1k 1%; R_0603_HandSoldering
R4, R23: 270R 1%; R_0603_HandSoldering
R6, R19, R28, R29, R30, R35: 10k; R_1206_0603
R7, R8, R62, R70: 1k; R_1206_0603
R11, R12, R15, R16: 510R; R_1206_0603
R13, R20: 47R; R_1206_0603
R14, R50, R65: 10k; R_0603_HandSoldering
R17, R24, R33, R36: 20R; R_1206_0603
R31: 82R; R_1206_0603
R32: 33R; R_2512_HandSoldering
R34, R58, R59: k91; R_1206_0603
R37, R54: 13R; R_1206_0603
R38: 20; R_0603_HandSoldering
R40, R42, R43, R46, R47: 4.7k 1%; R_0603_HandSoldering
R41: 51; R_0603_HandSoldering
R44, R49: 15; R_0603_HandSoldering
R48: 4k75; R_0603_HandSoldering
R52, R53: 82; R_0603_HandSoldering
R56: 33R; R_1206_0603
R57: 5R1; R_1206_0603
R60: k56; R_1206_0603
R61, R64: 2.2k; R_Axial_DIN0204_L3.6mm_D1.6mm_P2.54mm_Vertical
R63: k510; R_1206_0603
R66: 1k; R_0603_HandSoldering
R67: 1k5; R_1206_0603
R68, R69: 2k2; R_1206_0603
R71, R74: 1R; R_0603_HandSoldering
R72: 4.7k; R_1206_0603
R73: 330; R_1206_0603
RV1: 5k; Potentiometer_Trimmer_Bourns_3296W
T1: 1:4; TRANSF1_4
T2: 1_9; HF1_9
U1, U8: MC33179DR2G; SOIC-14_3.9x8.7mm_Pitch1.27mm
U2, U25, U26: PE4259ds; SOT-363_SC-70-6_Handsoldering
U3, U10: 74LVC1G3157; SOT-23-6_Handsoldering
U5: LD1117v25; SOT-223
U6, U14: 74HC4053; SOIC-16_3.9x9.9mm_Pitch1.27mm
U7, U11: SN74LVC1G00DCKR; SOT-353_SC-70-5_Handsoldering
U9: 74LCX574; SSOP-20_5.3x7.2mm_Pitch0.65mm
U15: L78M09; TO-252-2_Rectifier
U18: Si570; Oscillator_SMD_SI570_SI571_HandSoldering
U27: LM78L06ACZ; TO-92_Inline_Wide
Y5: 8Mhz; Crystal_HC49-U_Vertical

Connections:
/0: U3.6 (S), U9.6 (D4), U9.16 (Q3)
/0_1: R17.1, U3.3 (Y0)
/0_2: R18.1, U1.3 (+), U14.1 (Y1)
/0_3: R47.2, U8.8, U14.2 (Y0)
/2,75V: C82.1, C83.1, L4.1, R16.1, U5.2 (VO), U5.4 (VO)
/90: U9.5 (D3), U9.17 (Q2), U10.6 (S)
/90_1: R33.1, U10.3 (Y0)
/90_2: R10.2, U1.10 (+), U6.1 (Y1)
/90_3: R42.2, U6.2 (Y0), U8.14
/180_1: R24.1, U3.1 (Y1)
/180_2: R27.2, U1.5 (+), U14.3 (Z0)
/180_3: C69.1, R46.1, R48.1, U8.7, U14.5 (Z0)
/270_1: R36.1, U10.1 (Y1)
/270_2: R1.1, U1.12 (+), U6.3 (Z0)
/270_3: C60.1, R40.2, R43.2, U6.5 (Z0), U8.1
GND: C1.2, C2.2, C3.2, C4.2, C5.2, C6.2, C7.2, C10.1, C11.2, C12.2, C13.2, C14.2, C17.2, C18.2, C20.2, C21.2, C22.2, C23.2, C24.1, C25.1, C27.1, C28.1, C31.2, C33.2, C34.1, C36.1, C37.1, C38.1, C39.1, C40.1, C42.2, C43.2, C45.1, C46.2, C47.2, C49.1, C51.2, C52.2, C53.2, C54.1, C55.2, C56.1, C59.2, C61.1, C62.1, C63.1, C64.2, C65.1, C67.1, C68.2, C73.2, C74.2, C75.2, C76.2, C77.2, C78.2, C79.2, C80.2, C81.1, C82.2, C83.2, C84.1, C85.1, C87.2, C88.1, C90.1, C91.1, C92.2, C97.1, C98.2, C100.1, C101.1, C102.1, C103.1, C104.1, C105.1, C106.1, C107.1, C108.1, C109.1, C110.1, C111.2, CON1.2, CON1.3, D11.1 (K), J2.1 (T), L8.2, L9.2, L14.2, L15.2, L17.2, L18.2, L20.2, L21.2, L24.2, P1.2 (Ext), P2.6, P4.2, P5.4, P11.1, P12.1, P13.1, Q1.3 (S), Q2.2 (E), Q5.2 (E), Q6.2 (E), R6.2, R8.2, R11.1, R15.2, R28.2, R29.2, R30.2, R31.2, R35.2, R37.2, R52.1, R53.1, R54.2, R58.2, R59.2, R67.2, RV1.2, RV1.3, U1.11 (V-), U2.2 (GND), U3.2 (GND), U6.6 (Inh), U6.7 (VEE), U6.8 (VSS), U7.3 (GND), U8.11 (V-), U9.1 (OE), U9.7 (D5), U9.8 (D6), U9.9 (D7), U9.10 (GND), U10.2 (GND), U11.3 (GND), U14.6 (Inh), U14.7 (VEE), U14.8 (VSS), U15.2 (GND), U18.3 (GND), U25.2 (GND), U26.2 (GND), U27.2 (GND); also elsewhere on the board
unnamed: C1.1, C6.1, C7.1, R1.2, R2.1, R10.1, R11.2, R12.1, R18.2, R21.1, R27.1, U8.3 (+), U8.5 (+), U8.10 (+), U8.12 (+)
unnamed: C2.1, C5.1, L3.1, R12.2, U1.4 (V+)
unnamed: C8.1, R13.1
unnamed 19: C8.2; also elsewhere on the board
unnamed: C9.1, R20.1
unnamed 21: C9.2; also elsewhere on the board
unnamed 22: C11.1, Y5.2; also elsewhere on the board
unnamed 23: C12.1, Y5.1; also elsewhere on the board
unnamed: C13.1, C14.1, L5.2, R15.1, R16.2
unnamed: C15.1, C16.1, C29.1, K1.1 (C1), K1.12
unnamed: C15.2, C16.2, C29.2, P1.1 (In), R6.1, R28.1, R29.1, R30.1
unnamed: C19.1, U6.15 (Y)
unnamed: C19.2, C23.1, R17.2
unnamed 29: C20.1, C31.1, L25.2; also elsewhere on the board
unnamed: C21.1, C22.1, L4.2, L22.1, U3.5 (Vcc), U10.5 (Vcc)
unnamed: C26.1, L7.2
unnamed 32: C26.2, C28.2, L9.1; also elsewhere on the board
unnamed 33: C27.2, L7.1, L8.1; also elsewhere on the board
unnamed: C30.1, U6.4 (Z)
unnamed: C30.2, C33.1, R24.2
unnamed: C32.1, L11.2
unnamed 37: C32.2, C38.2, C39.2, L15.1; also elsewhere on the board
unnamed: C34.2, C56.2, Q2.3 (C), R14.2, U6.9 (C), U6.10 (B), U6.11 (A), U14.9 (C), U14.10 (B), U14.11 (A)
unnamed 39: C35.1; also elsewhere on the board
unnamed: C35.2, L5.1, U3.4 (Z), U10.4 (Z)
unnamed 41: C36.2, C37.2, L11.1, L14.1; also elsewhere on the board
unnamed: C40.2, C42.1, C54.2, C67.2, L2.1, T1.3
unnamed: C41.1, U14.15 (Y)
unnamed: C41.2, C43.1, R33.2
unnamed: C44.1, C50.1, L16.2
unnamed 46: C44.2, C49.2, C50.2, L18.1; also elsewhere on the board
unnamed 47: C45.2, L16.1, L17.1; also elsewhere on the board
unnamed: C46.1, C47.1, L22.2, R7.1, U7.5 (VCC), U9.20 (VCC), U11.5 (VCC)
unnamed: C48.1, U14.4 (Z)
unnamed: C48.2, C51.1, R36.2
unnamed: C52.1, C53.1, L10.2, U8.4 (V+)
unnamed: C57.1, L19.2
unnamed 53: C57.2, C63.2, C65.2, L21.1; also elsewhere on the board
unnamed: C58.1, R39.1
unnamed: C58.2, C59.1, L12.1
unnamed: C60.2, R39.2, R43.1, U8.2 (-)
unnamed 57: C61.2, C62.2, L19.1, L20.1; also elsewhere on the board
unnamed: C64.1, C66.2, L13.1
unnamed: C66.1, R45.1
unnamed: C69.2, R45.2, R46.2, U8.6 (-)
unnamed: C70.1, L23.1
unnamed: C70.2, Q3.4 (C), T2.1
unnamed: C71.1, R7.2, R8.1, U11.1, U11.2
unnamed: C71.2, U18.4 (CLK+)
unnamed: C72.1, T2.4, T2.5
unnamed: C72.2, Q1.1 (G), R35.1, R56.1
unnamed: C73.1, C80.1, L26.1, R50.1, R61.1, R64.1, U18.6 (VDD)
unnamed: C76.1, C77.1, C78.1, C79.1, L1.1, L3.2, L10.1, L25.1, U5.3 (VI), U15.3 (OUT)
unnamed: C81.2, C88.2, C92.1, L6.2, R32.1, U27.3 (IN)
unnamed: C84.2, C85.2, R32.2, T2.6
unnamed: C86.1, U2.1 (RF1)
unnamed: C86.2, R57.1, R59.1
unnamed: C87.1, Q4.3 (C), R62.2, R63.2, R65.1
unnamed 74: C89.1; also elsewhere on the board
unnamed: C89.2, U26.5 (RFC)
unnamed: C90.2, Q4.2 (E), R67.1, U27.1 (OUT)
unnamed: C93.2, D1.2 (A), K1.8, Q6.3 (C)
unnamed 78: C94.1, C95.1, D12.5 (VDD), R72.1, R73.1; also elsewhere on the board
unnamed 79: C94.2, C95.2, C96.2, D12.2 (GND), P3.5 (GND), P3.6 (shield); also elsewhere on the board
unnamed 80: C96.1; also elsewhere on the board
unnamed 81: C97.2; also elsewhere on the board
unnamed 82: C104.2; also elsewhere on the board
unnamed 83: C105.2, U25.4 (CTRL), U26.4 (CTRL); also elsewhere on the board
unnamed 84: C106.2; also elsewhere on the board
unnamed 85: C107.2; also elsewhere on the board
unnamed 86: C108.2; also elsewhere on the board
unnamed 87: C109.2, R68.2; also elsewhere on the board
unnamed 88: C110.2, R19.2; also elsewhere on the board
unnamed 89: C111.1, R69.1; also elsewhere on the board
unnamed: D11.2 (A), R70.2
unnamed 92: D12.3 (I/O1), P3.3 (D+); also elsewhere on the board
unnamed 93: D12.4 (I/O2), P3.2 (D-); also elsewhere on the board
unnamed 94: P5.3; also elsewhere on the board
unnamed 95: P2.4; also elsewhere on the board
unnamed 96: P2.1; also elsewhere on the board
unnamed 97: P2.3; also elsewhere on the board
unnamed 98: R70.1; also elsewhere on the board
unnamed 99: P4.1; also elsewhere on the board
unnamed 100: R64.2, U18.7 (SDA); also elsewhere on the board
unnamed 101: R61.2, U18.8 (SCL); also elsewhere on the board
unnamed 102: P2.5; also elsewhere on the board
unnamed 105: P5.2; also elsewhere on the board
unnamed: J2.2 (R), J2.3 (RN), L13.2
unnamed: J2.4 (SN), J2.5 (S), L12.2
unnamed: K1.6 (T1), T1.2
unnamed: K1.7 (R1), L24.1, U2.3 (RF2)
unnamed: L23.2, R34.2
unnamed: P3.1 (VCC), R73.2
unnamed: Q1.2 (D), T1.1, T1.4
unnamed: Q2.1 (B), R19.1
unnamed: Q3.1 (E), R54.1
unnamed: Q3.2 (B), R34.1, R57.2, R58.1, R60.1
unnamed: Q3.3 (C), R37.1
unnamed: Q4.1 (B), R65.2, R66.1
unnamed: Q5.1 (B), R68.1
unnamed: Q5.3 (C), R66.2
unnamed: Q6.1 (B), R69.2
unnamed: R2.2, R3.1, R4.1, U1.13 (-)
unnamed: R3.2, R5.2, U1.14
unnamed: R4.2, R5.1, R9.1, U1.9 (-)
unnamed: R9.2, R13.2, U1.8
unnamed: R20.2, R26.2, U1.7
unnamed: R21.2, R22.1, R23.1, U1.2 (-)
unnamed: R22.2, R25.2, U1.1
unnamed: R23.2, R25.1, R26.1, U1.6 (-)
unnamed: R31.1, U5.1 (GND)
unnamed: R38.1, R41.1
unnamed: R38.2, R44.2, U25.1 (RF1)
unnamed: R40.1, R42.1, U8.13 (-)
unnamed: R41.2, R49.2, U26.1 (RF1)
unnamed: R44.1, R52.2
unnamed: R47.1, R48.2, U8.9 (-)
unnamed: R49.1, R53.2
unnamed: R50.2, U18.2 (OE)
unnamed: R56.2, R63.1, RV1.1
unnamed: R60.2, R62.1
unnamed 140: R71.2, R74.2; also elsewhere on the board
unnamed 141: R72.2; also elsewhere on the board
unnamed: T2.2, T2.3
unnamed: U2.5 (RFC), U25.5 (RFC)
unnamed: U7.1, U7.2, U9.4 (D2), U9.18 (Q1)
unnamed: U7.4, U9.2 (D0)
unnamed: U9.3 (D1), U9.19 (Q0)
unnamed: U9.11 (Cp), U11.4
unnamed: U25.3 (RF2), U26.3 (RF2)
VDD: C3.1, C4.1, C17.1, C18.1, L1.2, R14.1, U6.16 (VDD), U14.16 (VDD)

Notes on the sheet:
80M
40M
20M
17..10M
10dB

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
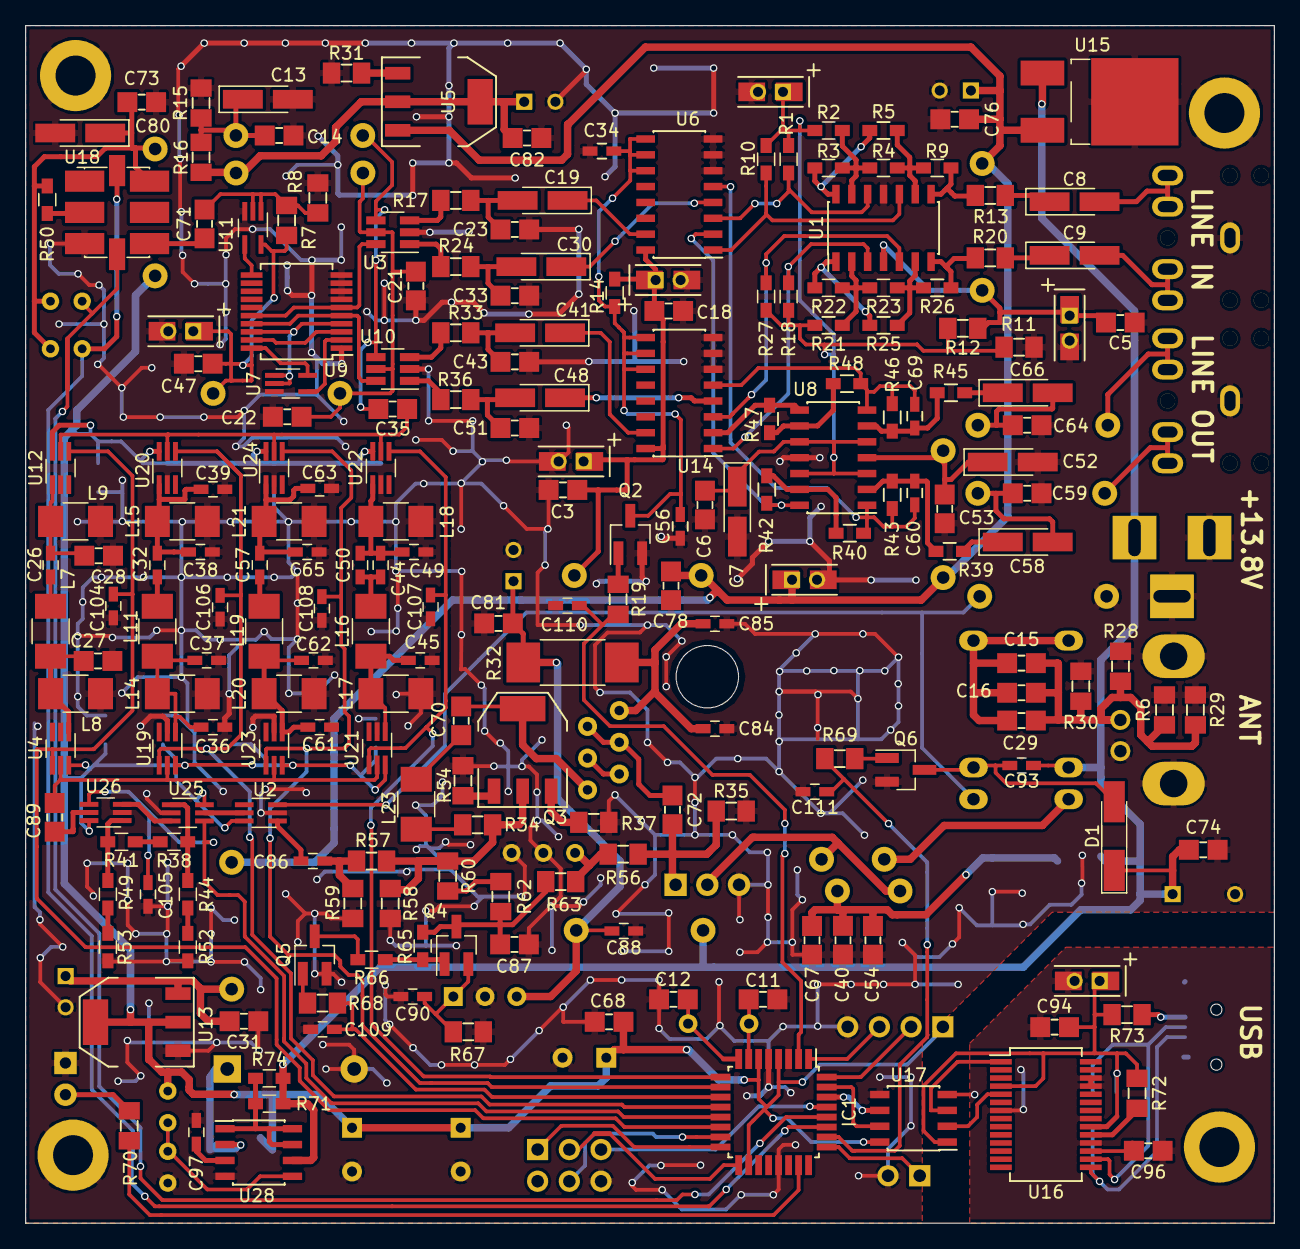
[picture p14: board PowerSupplay/LCSDR.kicad_pcb from above]

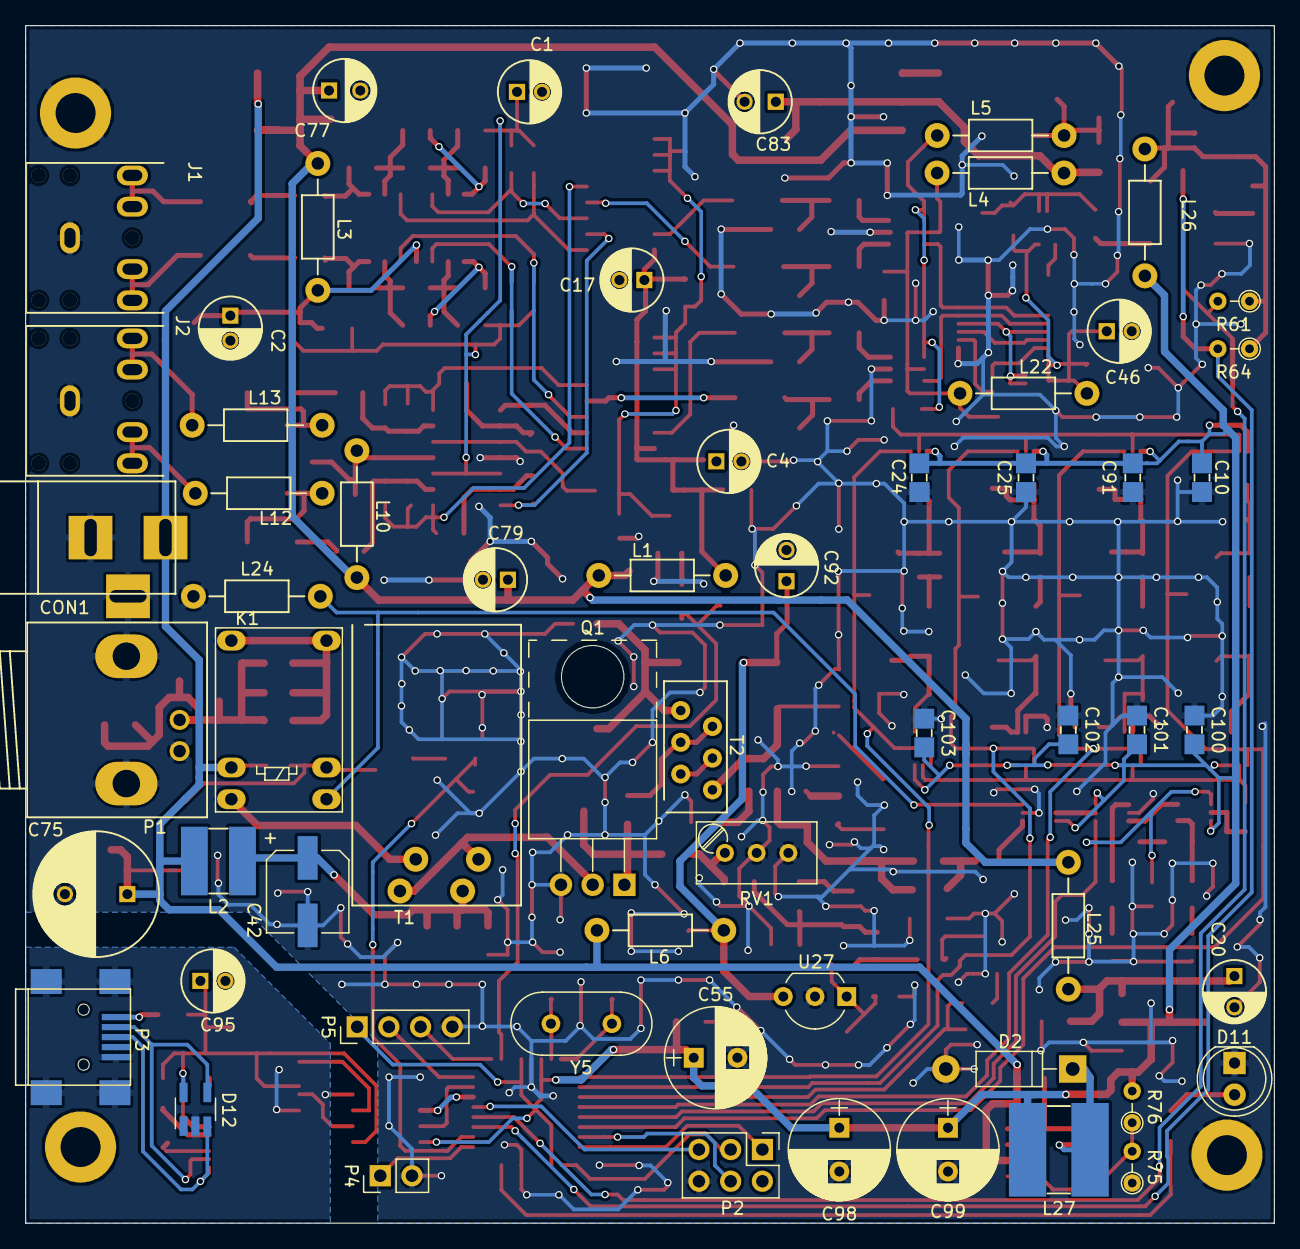
[picture p15: board PowerSupplay/LCSDR.kicad_pcb from below]

Board: 2 copper layers, 100.0 x 95.9 mm, 268 parts (60 on the bottom side), 155 nets.

Other parts of the board:
C99: 1000uF; CP_Radial_D8.0mm_P3.50mm
D2: 1N5819; D_DO-41_SOD81_P10.16mm_Horizontal
IC1: ATMEGA328-A; TQFP-32_7x7mm_Pitch0.8mm
J1: LINE IN; audio_jack_3_5mm_PJ307
L27: 33uH; Choke_CD75
R75: 11k; R_Axial_DIN0204_L3.6mm_D1.6mm_P2.54mm_Vertical
R76: 18k; R_Axial_DIN0204_L3.6mm_D1.6mm_P2.54mm_Vertical
U4, U12, U19, U20, U21, U22, U23, U24: PE4259ds; SOT-363_SC-70-6_Handsoldering
U13: LD1117v33; SOT-223
U16: FT232RL; SSOP-28_5.3x10.2mm_Pitch0.65mm
U17: ADuM1201BR; SOIC-8_3.9x4.9mm_Pitch1.27mm
U28: MC34063; SOIC-8_3.9x4.9mm_Pitch1.27mm

Their connections:
GND: C99.2, D2.2, IC1.3, IC1.5, IC1.21, J1.1, R75.1, U4.2, U12.2, U13.1, U17.5, U19.2, U20.2, U21.2, U22.2, U23.2, U24.2, U28.4; also elsewhere on the board
unnamed 19: J1.2, J1.3; also elsewhere on the board
unnamed 21: J1.4, J1.5; also elsewhere on the board
unnamed 22: IC1.7; also elsewhere on the board
unnamed 23: IC1.8; also elsewhere on the board
unnamed 29: U13.3; also elsewhere on the board
unnamed 32: U12.1; also elsewhere on the board
unnamed 33: U4.1; also elsewhere on the board
unnamed 37: U20.1; also elsewhere on the board
unnamed 39: U12.5, U20.5, U22.5, U24.5; also elsewhere on the board
unnamed 41: U19.1; also elsewhere on the board
unnamed 46: U22.1; also elsewhere on the board
unnamed 47: U21.1; also elsewhere on the board
unnamed 53: U24.1; also elsewhere on the board
unnamed 57: U23.1; also elsewhere on the board
unnamed 74: U4.5, U19.5, U21.5, U23.5; also elsewhere on the board
unnamed 78: U16.4, U16.20, U17.1; also elsewhere on the board
unnamed 79: U16.7, U16.18, U16.21, U16.25, U16.26, U17.4; also elsewhere on the board
unnamed 80: U16.17; also elsewhere on the board
unnamed 81: U28.3; also elsewhere on the board
unnamed 82: IC1.14, U4.4, U12.4; also elsewhere on the board
unnamed 83: IC1.13; also elsewhere on the board
unnamed 84: IC1.12, U19.4, U20.4; also elsewhere on the board
unnamed 85: IC1.9, U21.4, U22.4; also elsewhere on the board
unnamed 86: IC1.10, U23.4, U24.4; also elsewhere on the board
unnamed 87: IC1.11; also elsewhere on the board
unnamed 88: IC1.2; also elsewhere on the board
unnamed 89: IC1.26; also elsewhere on the board
unnamed: D2.1, L27.1, U28.2
unnamed 92: U16.15; also elsewhere on the board
unnamed 93: U16.16; also elsewhere on the board
unnamed 94: IC1.1; also elsewhere on the board
unnamed 95: IC1.15; also elsewhere on the board
unnamed 96: IC1.16; also elsewhere on the board
unnamed 97: IC1.17; also elsewhere on the board
unnamed 98: IC1.23; also elsewhere on the board
unnamed 99: IC1.25; also elsewhere on the board
unnamed 100: IC1.27; also elsewhere on the board
unnamed 101: IC1.28; also elsewhere on the board
unnamed 102: IC1.29; also elsewhere on the board
unnamed: IC1.30, U17.6
unnamed: IC1.31, U17.7
unnamed 105: IC1.32; also elsewhere on the board
unnamed 140: U28.1, U28.7, U28.8; also elsewhere on the board
unnamed 141: U16.19; also elsewhere on the board
unnamed: R75.2, R76.1, U28.5
unnamed: U16.1, U17.3
unnamed: U16.5, U17.2
