arsenal007/TRX_UT3MK_v23/(commit log)

2020-05-04 first edit
    [AUDIO_OUT.sch, IF.sch, LCSDR.kicad_pcb, LCSDR.sch, MCU.sch, MIXER.sch, PhaseRotators.sch, s1.sch]
2020-05-05 rotators 2 74lvc1G74
    [IF.sch, LCSDR.kicad_pcb, LCSDR.sch, MIXER.sch, PhaseRotators.sch, s1.sch, s2.sch]
2020-05-05 PCB s1
    [IF.sch, LCSDR.kicad_pcb, LCSDR.sch, MIXER.sch, PhaseRotators.sch, s1.sch, s2.sch]
2020-05-13 need some GND vias
    [74HC74.ms12, BPF.sch, IF.sch, LCSDR.kicad_pcb, LCSDR.sch, MCU.sch, MIXER.sch, PhaseRotators.sch]
2020-05-13 rm MIXERS
    [MIXERS.sch]
2020-05-30 Phase shift with 74LCX574 TSSOP-20
    [BPF.sch, IF.sch, LCSDR.kicad_pcb, LCSDR.sch, MIXER.sch, PhaseRotators.sch, s1.sch, s2.sch]
2020-06-03 instrumental amplifier in IF
    [BPF.sch, IF.sch, LCSDR.sch, MIXER.sch, PhaseRotators.sch, s1.sch, s2.sch]
2020-06-06 PCB 74LCX574
    [IF.sch, LCSDR.kicad_pcb, MIXER.sch, PhaseRotators.sch, s2.sch]
2020-06-06 gerber files
    [LCSDR.kicad_pcb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]
2020-06-08 fix PCB distance, right after mixer
    [LCSDR.kicad_pcb, microSD.sch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]
2020-06-09 rotate phase with 74LVC74APW
    [BPF.sch, IF.sch, LCSDR.kicad_pcb, LCSDR.sch, MIXER.sch, PhaseRotators.sch, s1.sch, s2.sch]
2020-07-06 add gnd vias
    [LCSDR.kicad_pcb]
